si-nalsal/pcb-mantis/connector (copy).kicad_sch.txt

(kicad_sch
	(version 20260306)
	(generator "eeschema")
	(generator_version "10.0")
	(uuid "03265686-2f84-4efa-9390-2dec67647ce7")
	(paper "A4")
	(title_block
		(title "Svayamkriya Vibhava")
		(company "Aksantara ITB")
	)
	(lib_symbols
		(symbol "Connector:Conn_01x02_Pin"
			(pin_names
				(offset 1.016)
				(hide yes)
			)
			(exclude_from_sim no)
			(in_bom yes)
			(on_board yes)
			(in_pos_files yes)
			(duplicate_pin_numbers_are_jumpers no)
			(property "Reference" "J"
				(at 0 2.54 0)
				(show_name no)
				(do_not_autoplace no)
				(effects
					(font
						(size 1.27 1.27)
					)
				)
			)
			(property "Value" "Conn_01x02_Pin"
				(at 0 -5.08 0)
				(show_name no)
				(do_not_autoplace no)
				(effects
					(font
						(size 1.27 1.27)
					)
				)
			)
			(property "Footprint" ""
				(at 0 0 0)
				(show_name no)
				(do_not_autoplace no)
				(hide yes)
				(effects
					(font
						(size 1.27 1.27)
					)
				)
			)
			(property "Datasheet" ""
				(at 0 0 0)
				(show_name no)
				(do_not_autoplace no)
				(hide yes)
				(effects
					(font
						(size 1.27 1.27)
					)
				)
			)
			(property "Description" "Generic connector, single row, 01x02, script generated"
				(at 0 0 0)
				(show_name no)
				(do_not_autoplace no)
				(hide yes)
				(effects
					(font
						(size 1.27 1.27)
					)
				)
			)
			(property "ki_locked" ""
				(at 0 0 0)
				(show_name no)
				(do_not_autoplace no)
				(effects
					(font
						(size 1.27 1.27)
					)
				)
			)
			(property "ki_keywords" "connector"
				(at 0 0 0)
				(show_name no)
				(do_not_autoplace no)
				(hide yes)
				(effects
					(font
						(size 1.27 1.27)
					)
				)
			)
			(property "ki_fp_filters" "Connector*:*_1x??_*"
				(at 0 0 0)
				(show_name no)
				(do_not_autoplace no)
				(hide yes)
				(effects
					(font
						(size 1.27 1.27)
					)
				)
			)
			(symbol "Conn_01x02_Pin_1_1"
				(rectangle
					(start 0.8636 0.127)
					(end 0 -0.127)
					(stroke
						(width 0.1524)
						(type default)
					)
					(fill
						(type outline)
					)
				)
				(rectangle
					(start 0.8636 -2.413)
					(end 0 -2.667)
					(stroke
						(width 0.1524)
						(type default)
					)
					(fill
						(type outline)
					)
				)
				(polyline
					(pts
						(xy 1.27 0) (xy 0.8636 0)
					)
					(stroke
						(width 0.1524)
						(type default)
					)
					(fill
						(type none)
					)
				)
				(polyline
					(pts
						(xy 1.27 -2.54) (xy 0.8636 -2.54)
					)
					(stroke
						(width 0.1524)
						(type default)
					)
					(fill
						(type none)
					)
				)
				(pin passive line
					(at 5.08 0 180)
					(length 3.81)
					(name "Pin_1"
						(effects
							(font
								(size 1.27 1.27)
							)
						)
					)
					(number "1"
						(effects
							(font
								(size 1.27 1.27)
							)
						)
					)
				)
				(pin passive line
					(at 5.08 -2.54 180)
					(length 3.81)
					(name "Pin_2"
						(effects
							(font
								(size 1.27 1.27)
							)
						)
					)
					(number "2"
						(effects
							(font
								(size 1.27 1.27)
							)
						)
					)
				)
			)
			(embedded_fonts no)
		)
		(symbol "Connector:Conn_01x03_Socket"
			(pin_names
				(offset 1.016)
				(hide yes)
			)
			(exclude_from_sim no)
			(in_bom yes)
			(on_board yes)
			(in_pos_files yes)
			(duplicate_pin_numbers_are_jumpers no)
			(property "Reference" "J"
				(at 0 5.08 0)
				(show_name no)
				(do_not_autoplace no)
				(effects
					(font
						(size 1.27 1.27)
					)
				)
			)
			(property "Value" "Conn_01x03_Socket"
				(at 0 -5.08 0)
				(show_name no)
				(do_not_autoplace no)
				(effects
					(font
						(size 1.27 1.27)
					)
				)
			)
			(property "Footprint" ""
				(at 0 0 0)
				(show_name no)
				(do_not_autoplace no)
				(hide yes)
				(effects
					(font
						(size 1.27 1.27)
					)
				)
			)
			(property "Datasheet" ""
				(at 0 0 0)
				(show_name no)
				(do_not_autoplace no)
				(hide yes)
				(effects
					(font
						(size 1.27 1.27)
					)
				)
			)
			(property "Description" "Generic connector, single row, 01x03, script generated"
				(at 0 0 0)
				(show_name no)
				(do_not_autoplace no)
				(hide yes)
				(effects
					(font
						(size 1.27 1.27)
					)
				)
			)
			(property "ki_locked" ""
				(at 0 0 0)
				(show_name no)
				(do_not_autoplace no)
				(effects
					(font
						(size 1.27 1.27)
					)
				)
			)
			(property "ki_keywords" "connector"
				(at 0 0 0)
				(show_name no)
				(do_not_autoplace no)
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
			)
		)
		(property "MPN" ""
			(at 240.03 57.15 0)
			(hide yes)
			(show_name no)
			(do_not_autoplace no)
			(effects
				(font
					(size 1.27 1.27)
				)
			)
		)
		(pin "10"
			(uuid "5faf5ca5-a9dc-4bd5-bea4-7c678d5fadc7")
		)
		(pin "4"
			(uuid "1208e7ed-2508-4eac-b18b-d2cbbdd8cb6e")
		)
		(pin "9"
			(uuid "406bfd20-a2a9-4eb4-803e-b73969eafc6d")
		)
		(pin "7"
			(uuid "932b8ec7-872d-498e-a7df-8b2aea224fba")
		)
		(pin "3"
			(uuid "539c2599-ec2d-4190-90a8-c909d4a950bc")
		)
		(pin "2"
			(uuid "92c30c23-30dd-4c9d-af76-a7bf393b6080")
		)
		(pin "6"
			(uuid "4ee2161a-e461-4d2e-9539-8ffbe4ac3db1")
		)
		(pin "5"
			(uuid "11e90bf2-4136-402e-a8d1-76ae9172d5fe")
		)
		(pin "8"
			(uuid "fd24c3a2-98c4-43d6-949b-77af67ea0eec")
		)
		(pin "1"
			(uuid "a705ce5e-21bf-4448-98fc-6fa667d10294")
		)
		(instances
			(project "SvayamV3_IIK"
				(path "/2845b085-eb04-41a1-8594-b2a880ca4ab0/62301ec1-b8c7-4fa7-aee1-8dbd1d010312"
					(reference "J7")
					(unit 1)
				)
			)
		)
	)
	(symbol
		(lib_id "Connector:Conn_01x07_Pin")
		(at 46.99 107.95 0)
		(mirror y)
		(unit 1)
		(body_style 1)
		(exclude_from_sim no)
		(in_bom yes)
		(on_board yes)
		(in_pos_files yes)
		(dnp yes)
		(fields_autoplaced yes)
		(uuid "18c9e688-f1d2-4cd7-b8b5-5cb62be1aed3")
		(property "Reference" "J21"
			(at 46.355 95.25 0)
			(show_name no)
			(do_not_autoplace no)
			(effects
				(font
					(size 1.27 1.27)
				)
			)
		)
		(property "Value" "SPI"
			(at 46.355 97.79 0)
			(show_name no)
			(do_not_autoplace no)
			(effects
				(font
					(size 1.27 1.27)
				)
			)
		)
		(property "Footprint" "Connector_JST:JST_GH_BM07B-GHS-TBT_1x07-1MP_P1.25mm_Vertical"
			(at 46.99 107.95 0)
			(hide yes)
			(show_name no)
			(do_not_autoplace no)
			(effects
				(font
					(size 1.27 1.27)
				)
			)
		)
		(property "Datasheet" ""
			(at 46.99 107.95 0)
			(hide yes)
			(show_name no)
			(do_not_autoplace no)
			(effects
				(font
					(size 1.27 1.27)
				)
			)
		)
		(property "Description" "Generic connector, single row, 01x07, script generated"
			(at 46.99 107.95 0)
			(hide yes)
			(show_name no)
			(do_not_autoplace no)
			(effects
				(font
					(size 1.27 1.27)
				)
			)
		)
		(property "MPN" ""
			(at 46.99 107.95 0)
			(hide yes)
			(show_name no)
			(do_not_autoplace no)
			(effects
				(font
					(size 1.27 1.27)
				)
			)
		)
		(pin "6"
			(uuid "288df99f-dae5-49ea-928c-db82f384212a")
		)
		(pin "7"
			(uuid "b9f9490f-fe2d-4c1c-935e-d4dd897e21a7")
		)
		(pin "4"
			(uuid "f30de5ce-285d-4f3a-ba5a-36126d62c0cd")
		)
		(pin "2"
			(uuid "916c0bb5-cfb0-42c9-8f4e-c7ee834b80be")
		)
		(pin "3"
			(uuid "2f8645a6-8778-4034-a83e-562c17ab7f0e")
		)
		(pin "1"
			(uuid "aa54f949-fe58-489f-ac60-cde8ec75a0ca")
		)
		(pin "5"
			(uuid "d0431252-0378-4e6b-ab2e-a6c766854e29")
		)
		(instances
			(project "SvayamV3_IIK"
				(path "/2845b085-eb04-41a1-8594-b2a880ca4ab0/62301ec1-b8c7-4fa7-aee1-8dbd1d010312"
					(reference "J21")
					(unit 1)
				)
			)
		)
	)
	(symbol
		(lib_id "Device:R")
		(at 36.83 55.88 270)
		(mirror x)
		(unit 1)
		(body_style 1)
		(exclude_from_sim no)
		(in_bom yes)
		(on_board yes)
		(in_pos_files yes)
		(dnp no)
		(uuid "18f2939e-c780-4f3e-8dc2-9bac9d83a237")
		(property "Reference" "R56"
			(at 43.434 54.864 90)
			(show_name no)
			(do_not_autoplace no)
			(effects
				(font
					(size 1.27 1.27)
				)
				(justify right)
			)
		)
		(property "Value" "120"
			(at 38.862 55.88 90)
			(show_name no)
			(do_not_autoplace no)
			(effects
				(font
					(size 1.27 1.27)
				)
				(justify right)
			)
		)
		(property "Footprint" "Resistor_SMD:R_0402_1005Metric"
			(at 36.83 57.658 90)
			(hide yes)
			(show_name no)
			(do_not_autoplace no)
			(effects
				(font
					(size 1.27 1.27)
				)
			)
		)
		(property "Datasheet" ""
			(at 36.83 55.88 0)
			(hide yes)
			(show_name no)
			(do_not_autoplace no)
			(effects
				(font
					(size 1.27 1.27)
				)
			)
		)
		(property "Description" "Resistor"
			(at 36.83 55.88 0)
			(hide yes)
			(show_name no)
			(do_not_autoplace no)
			(effects
				(font
					(size 1.27 1.27)
				)
			)
		)
		(property "MPN" "0402WGF1200TCE"
			(at 36.83 55.88 0)
			(hide yes)
			(show_name no)
			(do_not_autoplace no)
			(effects
				(font
					(size 1.27 1.27)
				)
			)
		)
		(pin "1"
			(uuid "8353e9d4-af14-414b-9c09-83cc79ee870e")
		)
		(pin "2"
			(uuid "7dce7579-1e03-49c3-901d-1a2f33d9af58")
		)
		(instances
			(project "SvayamV3_IIK"
				(path "/2845b085-eb04-41a1-8594-b2a880ca4ab0/62301ec1-b8c7-4fa7-aee1-8dbd1d010312"
					(reference "R56")
					(unit 1)
				)
			)
		)
	)
	(symbol
		(lib_id "power:GND")
		(at 34.29 187.96 0)
		(unit 1)
		(body_style 1)
		(exclude_from_sim no)
		(in_bom yes)
		(on_board yes)
		(in_pos_files yes)
		(dnp no)
		(fields_autoplaced yes)
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
			(at 252.73 130.81 0)
			(hide yes)
			(show_name no)
			(do_not_autoplace no)
			(effects
				(font
					(size 1.27 1.27)
				)
			)
		)
		(property "MPN" "1040310811"
			(at 252.73 130.81 0)
			(hide yes)
			(show_name no)
			(do_not_autoplace no)
			(effects
				(font
					(size 1.27 1.27)
				)
			)
		)
		(pin "8"
			(uuid "cb6624f8-a1e8-49c2-84a5-bef0e999a261")
		)
		(pin "7"
			(uuid "d5033a53-cf56-4719-aa6e-07890199050d")
		)
		(pin "5"
			(uuid "993f321e-2bf0-49b4-9d45-fda569c61765")
		)
		(pin "6"
			(uuid "1bfad961-9bcc-41d8-80f4-651ca0a691e3")
		)
		(pin "9"
			(uuid "e06dffd2-5b84-4b25-ab86-bc74e01b0dd9")
		)
		(pin "4"
			(uuid "eb05ebf3-bc08-4bf6-b3bc-95f3cf43d655")
		)
		(pin "10"
			(uuid "8a9c7bf7-9211-48c9-ad3b-dce50b0c11e4")
		)
		(pin "1"
			(uuid "30ea762a-e999-4649-bf35-5b8d219369ba")
		)
		(pin "3"
			(uuid "5db72ffa-984e-4d56-9220-41458373f673")
		)
		(pin "2"
			(uuid "7336b55d-bf80-46e8-8c3e-e9e0fc80735a")
		)
		(instances
			(project "SvayamV3_IIK"
				(path "/2845b085-eb04-41a1-8594-b2a880ca4ab0/62301ec1-b8c7-4fa7-aee1-8dbd1d010312"
					(reference "J2")
					(unit 1)
				)
			)
		)
	)
	(symbol
		(lib_id "power:+3V3")
		(at 74.93 148.59 0)
		(unit 1)
		(body_style 1)
		(exclude_from_sim no)
		(in_bom yes)
		(on_board yes)
		(in_pos_files yes)
		(dnp no)
		(uuid "63fd7163-d494-418c-9f1c-1702d7ba05cc")
		(property "Reference" "#PWR086"
			(at 74.93 152.4 0)
			(hide yes)
			(show_name no)
			(do_not_autoplace no)
			(effects
				(font
					(size 1.27 1.27)
				)
			)
		)
		(property "Value" "+VBUS"
			(at 70.612 144.526 0)
			(show_name no)
			(do_not_autoplace no)
			(effects
				(font
					(size 1.27 1.27)
				)
				(justify left)
			)
		)
		(property "Footprint" ""
			(at 74.93 148.59 0)
			(hide yes)
			(show_name no)
			(do_not_autoplace no)
			(effects
				(font
					(size 1.27 1.27)
				)
			)
		)
		(property "Datasheet" ""
			(at 74.93 148.59 0)
			(hide yes)
			(show_name no)
			(do_not_autoplace no)
			(effects
				(font
					(size 1.27 1.27)
				)
			)
		)
		(property "Description" "Power symbol creates a global label with name \"+3V3\""
			(at 74.93 148.59 0)
			(hide yes)
			(show_name no)
			(do_not_autoplace no)
			(effects
				(font
					(size 1.27 1.27)
				)
			)
		)
		(pin "1"
			(uuid "fac0508f-6b04-46f6-8075-e6ba6fb24d24")
		)
		(instances
			(project "SvayamV3_IIK"
				(path "/2845b085-eb04-41a1-8594-b2a880ca4ab0/62301ec1-b8c7-4fa7-aee1-8dbd1d010312"
					(reference "#PWR086")
					(unit 1)
				)
			)
		)
	)
	(symbol
		(lib_id "Connector:Conn_01x03_Socket")
		(at 104.14 44.45 0)
		(unit 1)
		(body_style 1)
		(exclude_from_sim no)
		(in_bom yes)
		(on_board yes)
		(in_pos_files yes)
		(dnp yes)
		(fields_autoplaced yes)
		(uuid "66f18fe3-e061-4741-9793-27d07f73b41f")
		(property "Reference" "J18"
			(at 105.41 43.1799 0)
			(show_name no)
			(do_not_autoplace no)
			(effects
				(font
					(size 1.27 1.27)
				)
				(justify left)
			)
		)
		(property "Value" "BUZZER"
			(at 105.41 45.7199 0)
			(show_name no)
			(do_not_autoplace no)
			(effects
				(font
					(size 1.27 1.27)
				)
				(justify left)
			)
		)
		(property "Footprint" "Connector_JST:JST_GH_BM03B-GHS-TBT_1x03-1MP_P1.25mm_Vertical"
			(at 104.14 44.45 0)
			(hide yes)
			(show_name no)
			(do_not_autoplace no)
			(effects
				(font
					(size 1.27 1.27)
				)
			)
		)
		(property "Datasheet" ""
			(at 104.14 44.45 0)
			(hide yes)
			(show_name no)
			(do_not_autoplace no)
			(effects
				(font
					(size 1.27 1.27)
				)
			)
		)
		(property "Description" "Generic connector, single row, 01x03, script generated"
			(at 104.14 44.45 0)
			(hide yes)
			(show_name no)
			(do_not_autoplace no)
			(effects
				(font
					(size 1.27 1.27)
				)
			)
		)
		(property "MPN" ""
			(at 104.14 44.45 0)
			(hide yes)
			(show_name no)
			(do_not_autoplace no)
			(effects
				(font
					(size 1.27 1.27)
				)
			)
		)
		(pin "3"
			(uuid "60e7030a-febb-4282-b92f-761420e810f0")
		)
		(pin "1"
			(uuid "5442ed96-bc10-46ac-b1f5-2626b62a5412")
		)
		(pin "2"
			(uuid "1a9f50e6-1e32-49f7-9bb9-00bd1e115986")
		)
		(instances
			(project "SvayamV3_IIK"
				(path "/2845b085-eb04-41a1-8594-b2a880ca4ab0/62301ec1-b8c7-4fa7-aee1-8dbd1d010312"
					(reference "J18")
					(unit 1)
				)
			)
		)
	)
	(symbol
		(lib_id "Connector:Conn_01x06_Pin")
		(at 240.03 29.21 0)
		(unit 1)
		(body_style 1)
		(exclude_from_sim no)
		(in_bom yes)
		(on_board yes)
		(in_pos_files yes)
		(dnp yes)
		(uuid "70888625-afd2-4ff5-a54f-43112737d458")
		(property "Reference" "J4"
			(at 240.665 19.05 0)
			(show_name no)
			(do_not_autoplace no)
			(effects
				(font
					(size 1.27 1.27)
				)
			)
		)
		(property "Value" "S_TOP_PWR"
			(at 240.665 21.59 0)
			(show_name no)
			(do_not_autoplace no)
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
				(path "/2845b085-eb04-41a1-8594-b2a880ca4ab0/62301ec1-b8c7-4fa7-aee1-8dbd1d010312"
					(reference "R25")
					(unit 1)
				)
			)
		)
	)
	(symbol
		(lib_id "Connector:USB_C_Receptacle_USB2.0_16P")
		(at 34.29 163.83 0)
		(unit 1)
		(body_style 1)
		(exclude_from_sim no)
		(in_bom yes)
		(on_board yes)
		(in_pos_files yes)
		(dnp no)
		(fields_autoplaced yes)
		(uuid "c4829fad-b5e2-4201-a339-db18e4ded1f6")
		(property "Reference" "J1"
			(at 34.29 140.97 0)
			(show_name no)
			(do_not_autoplace no)
			(effects
				(font
					(size 1.27 1.27)
				)
			)
		)
		(property "Value" "USB_C_Receptacle_USB2.0_16P"
			(at 34.29 143.51 0)
			(show_name no)
			(do_not_autoplace no)
			(effects
				(font
					(size 1.27 1.27)
				)
			)
		)
		(property "Footprint" "easyeda2kicad:USB-C-SMD_TYPE-C16PIN"
			(at 38.1 163.83 0)
			(hide yes)
			(show_name no)
			(do_not_autoplace no)
			(effects
				(font
					(size 1.27 1.27)
				)
			)
		)
		(property "Datasheet" "https://www.usb.org/sites/default/files/documents/usb_type-c.zip"
			(at 38.1 163.83 0)
			(hide yes)
			(show_name no)
			(do_not_autoplace no)
			(effects
				(font
					(size 1.27 1.27)
				)
			)
		)
		(property "Description" "USB 2.0-only 16P Type-C Receptacle connector"
			(at 34.29 163.83 0)
			(hide yes)
			(show_name no)
			(do_not_autoplace no)
			(effects
				(font
					(size 1.27 1.27)
				)
			)
		)
		(property "MPN" "TYPE-C16PIN"
			(at 34.29 163.83 0)
			(hide yes)
			(show_name no)
			(do_not_autoplace no)
			(effects
				(font
					(size 1.27 1.27)
				)
			)
		)
		(pin "B8"
			(uuid "db181596-cf46-47b6-a408-663041a7f4fd")
		)
		(pin "A7"
			(uuid "c0e09dfd-21cf-4c7e-bd06-315c416275d8")
		)
		(pin "A1"
			(uuid "74b0fce0-470e-4f8b-9161-8ce03450caf1")
		)
		(pin "B9"
			(uuid "69491447-4349-4a7c-a44a-8b59ee2ec28e")
		)
		(pin "A4"
			(uuid "0c3d424d-8a51-4b5d-a7ea-090fd09bc773")
		)
		(pin "B4"
			(uuid "c3caafd2-da87-4897-a4a4-4b574669baf9")
		)
		(pin "B1"
			(uuid "2f8629b2-707a-463e-8b76-95569479ec8e")
		)
		(pin "B7"
			(uuid "52371f4a-9e05-443f-989e-7d06c8298733")
		)
		(pin "A5"
			(uuid "d6624947-ba8a-4f8c-9232-5fb9c6404ed8")
		)
		(pin "B6"
			(uuid "035ad77f-19e3-431d-a522-fd0e5fde45c7")
		)
		(pin "A12"
			(uuid "10726012-93a9-4aa6-b8f0-2641798eb760")
		)
		(pin "A9"
			(uuid "70ab6524-c4cd-4f23-b672-b27a699ab554")
		)
		(pin "A8"
			(uuid "8048cba8-2139-4dd7-bb9a-27b2c1656934")
		)
		(pin "B5"
			(uuid "c59acc48-44ca-4bcc-abdf-0167ccc85853")
		)
		(pin "S1"
			(uuid "5e77efb9-58d6-47e2-8f87-1d94c796d1b4")
		)
		(pin "B12"
			(uuid "077311d9-3f3e-4e68-9a96-4f02640ec5a4")
		)
		(pin "A6"
			(uuid "9e67610e-7504-4989-97e8-7b37c6cc6fc5")
		)
		(instances
			(project "SvayamV3_IIK"
				(path "/2845b085-eb04-41a1-8594-b2a880ca4ab0/62301ec1-b8c7-4fa7-aee1-8dbd1d010312"
					(reference "J1")
					(unit 1)
				)
			)
		)
	)
	(symbol
		(lib_id "power:GND")
		(at 124.46 46.99 0)
		(unit 1)
		(body_style 1)
		(exclude_from_sim no)
		(in_bom yes)
		(on_board yes)
		(in_pos_files yes)
		(dnp no)
		(fields_autoplaced yes)
		(uuid "c66d8db5-72ca-4785-af80-80bd893ed88d")
		(property "Reference" "#PWR066"
			(at 124.46 53.34 0)
			(hide yes)
			(show_name no)
			(do_not_autoplace no)
			(effects
				(font
					(size 1.27 1.27)
				)
			)
		)
		(property "Value" "GND"
			(at 124.46 52.07 0)
			(hide yes)
			(show_name no)
			(do_not_autoplace no)
			(effects
				(font
					(size 1.27 1.27)
				)
			)
		)
		(property "Footprint" ""
			(at 124.46 46.99 0)
			(hide yes)
			(show_name no)
			(do_not_autoplace no)
			(effects
				(font
					(size 1.27 1.27)
				)
			)
		)
		(property "Datasheet" ""
			(at 124.46 46.99 0)
			(hide yes)
			(show_name no)
			(do_not_autoplace no)
			(effects
				(font
					(size 1.27 1.27)
				)
			)
		)
		(property "Description" "Power symbol creates a global label with name \"GND\" , ground"
			(at 124.46 46.99 0)
			(hide yes)
			(show_name no)
			(do_not_autoplace no)
			(effects
				(font
					(size 1.27 1.27)
				)
			)
		)
		(pin "1"
			(uuid "8cca001b-2362-4ba5-9bf1-b4a389a86623")
		)
		(instances
			(project "SvayamV3_IIK"
				(path "/2845b085-eb04-41a1-8594-b2a880ca4ab0/62301ec1-b8c7-4fa7-aee1-8dbd1d010312"
					(reference "#PWR066")
					(unit 1)
				)
			)
		)
	)
	(symbol
		(lib_id "power:GND")
		(at 82.55 116.84 0)
		(unit 1)
		(body_style 1)
		(exclude_from_sim no)
		(in_bom yes)
		(on_board yes)
		(in_pos_files yes)
		(dnp no)
		(fields_autoplaced yes)
		(uuid "ca408961-e181-4023-bc09-9be4eecc3f4a")
		(property "Reference" "#PWR083"
			(at 82.55 123.19 0)
			(hide yes)
			(show_name no)
			(do_not_autoplace no)
			(effects
				(font
					(size 1.27 1.27)
				)
			)
		)
		(property "Value" "GND"
			(at 82.55 121.92 0)
			(hide yes)
			(show_name no)
			(do_not_autoplace no)
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
		(pin "6"
			(uuid "53d4a27d-80dc-40ea-b209-8d5194c79de0")
		)
		(pin "5"
			(uuid "7b395a92-bbfb-4322-a0f9-9bb482e9858a")
		)
		(pin "8"
			(uuid "9f4d6d41-09d1-4738-82e4-76208527cabb")
		)
		(pin "1"
			(uuid "095797fb-270a-4e6a-b961-59d8233d917d")
		)
		(instances
			(project "SvayamV3_IIK"
				(path "/2845b085-eb04-41a1-8594-b2a880ca4ab0/62301ec1-b8c7-4fa7-aee1-8dbd1d010312"
					(reference "J6")
					(unit 1)
				)
			)
		)
	)
	(symbol
		(lib_id "Device:R")
		(at 212.09 34.29 270)
		(mirror x)
		(unit 1)
		(body_style 1)
		(exclude_from_sim no)
		(in_bom yes)
		(on_board yes)
		(in_pos_files yes)
		(dnp no)
		(uuid "ff7dfa34-54f1-4ce1-b958-6582d1e44b65")
		(property "Reference" "R30"
			(at 218.694 33.274 90)
			(show_name no)
			(do_not_autoplace no)
			(effects
				(font
					(size 1.27 1.27)
				)
				(justify right)
			)
		)
		(property "Value" "120"
			(at 214.122 34.29 90)
			(show_name no)
			(do_not_autoplace no)
			(effects
				(font
					(size 1.27 1.27)
				)
				(justify right)
			)
		)
		(property "Footprint" "Resistor_SMD:R_0402_1005Metric"
			(at 212.09 36.068 90)
			(hide yes)
			(show_name no)
			(do_not_autoplace no)
			(effects
				(font
					(size 1.27 1.27)
				)
			)
		)
		(property "Datasheet" ""
			(at 212.09 34.29 0)
			(hide yes)
			(show_name no)
			(do_not_autoplace no)
			(effects
				(font
					(size 1.27 1.27)
				)
			)
		)
		(property "Description" "Resistor"
			(at 212.09 34.29 0)
			(hide yes)
			(show_name no)
			(do_not_autoplace no)
			(effects
				(font
					(size 1.27 1.27)
				)
			)
		)
		(property "MPN" "0402WGF1200TCE"
			(at 212.09 34.29 0)
			(hide yes)
			(show_name no)
			(do_not_autoplace no)
			(effects
				(font
					(size 1.27 1.27)
				)
			)
		)
		(pin "1"
			(uuid "c29a343e-6693-4ea5-8234-664a20f62edb")
		)
		(pin "2"
			(uuid "2394d375-28b8-440f-bd87-5712573b2a9d")
		)
		(instances
			(project "SvayamV3_IIK"
				(path "/2845b085-eb04-41a1-8594-b2a880ca4ab0/62301ec1-b8c7-4fa7-aee1-8dbd1d010312"
					(reference "R30")
					(unit 1)
				)
			)
		)
	)
)
