si-nalsal/pcb-mantis/docs/images/pcb-bottom.png

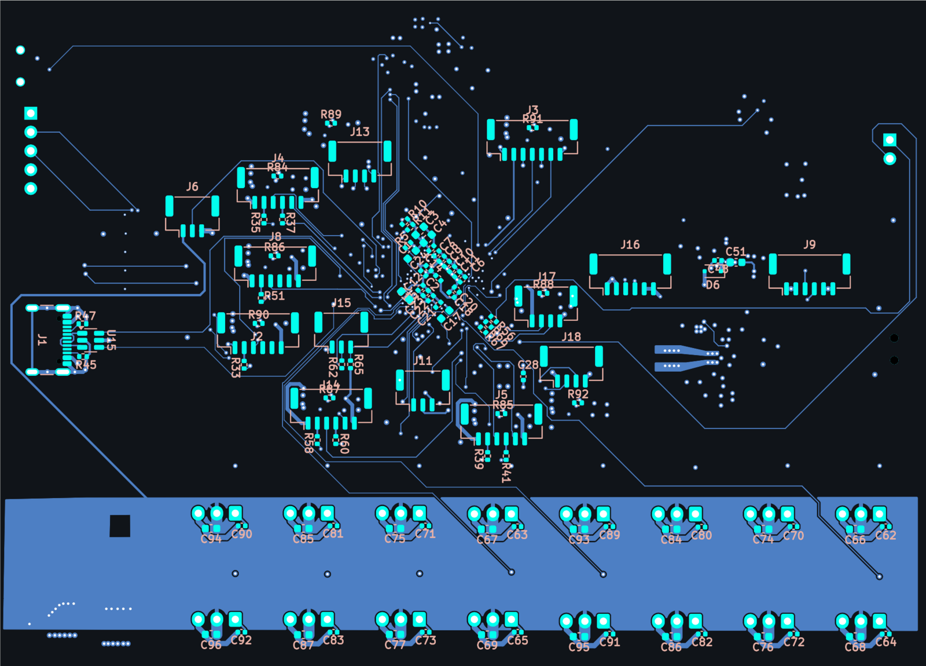
docs/images/pcb-bottom.png
