si-nalsal/pcb-mantis/docs/bom.csv

Refs | Value | Footprint | MPN | LCSC
C1,C4,C59,C66-C69,C74-C77,C79,C84-C87,C93-C114 | 1u | Capacitor_SMD:C_0603_1608Metric | CL10A105KB8NNNC
C2,C5-C12,C14,C15,C18,C20-C39,C44,C45,C48,C49,C60,C62-C65,C70-C73,C80-C83,C88-C92 | 100n | Capacitor_SMD:C_0402_1005Metric | CL05B104KB54PNC
C3,C42,C43,C55-C58 | 4u7 | Capacitor_SMD:C_0603_1608Metric | CL10A475KO8NNNC
C13,C16 | 33p | Capacitor_SMD:C_0402_1005Metric | 0402CG330J500NT
C17,C19 | 2u2 | Capacitor_SMD:C_0603_1608Metric | CL10A225KO8NNNC
C40,C41 | 10u | Capacitor_SMD:C_0805_2012Metric
C46,C50,C51,C61 | 10u | Capacitor_SMD:C_0603_1608Metric | CL10A106MA8NRNC
C47 | 100n | Capacitor_SMD:C_0805_2012Metric
C52-C54 | 22u | Capacitor_SMD:C_0805_2012Metric
C78 | 220u | Capacitor_SMD:CP_Elec_6.3x7.7
D1 | PWR | Diode_SMD:D_0603_1608Metric | NCD0603R1
D2 | BOOT | Diode_SMD:D_0603_1608Metric | NCD0603R1
D3 | STAT | Diode_SMD:D_0603_1608Metric | NCD0603R1
D4,D5,D8 | SMAJ6.0A | Diode_SMD:D_SMA
D6,D7 | PMEG1030EJ,115 | Diode_SMD:D_SOD-323F | PMEG1030EJ,115
J1 | USB_C_Receptacle_USB2.0_16P | easyeda2kicad:USB-C-SMD_TYPE-C16PIN | TYPE-C16PIN
J2 | GPS | Connector_JST:JST_GH_BM06B-GHS-TBT_1x06-1MP_P1.25mm_Vertical
J3 | SPI | Connector_JST:JST_GH_BM07B-GHS-TBT_1x07-1MP_P1.25mm_Vertical
J4 | TELEM1 | Connector_JST:JST_GH_BM06B-GHS-TBT_1x06-1MP_P1.25mm_Vertical
J5 | TELEM2 | Connector_JST:JST_GH_BM06B-GHS-TBT_1x06-1MP_P1.25mm_Vertical
J6 | SBUS | Connector_JST:JST_GH_BM03B-GHS-TBT_1x03-1MP_P1.25mm_Vertical
J7 | Conn_01x05_Pin | Connector_PinHeader_2.54mm:PinHeader_1x05_P2.54mm_Vertical
J8 | SERIAL4 | Connector_JST:JST_GH_BM06B-GHS-TBT_1x06-1MP_P1.25mm_Vertical
J9 | POWER1 | Connector_JST:JST_GH_BM06B-GHS-TBT_1x06-1MP_P1.25mm_Vertical
J10 | Micro_SD_Card_Det1 | Svayam:104031-0811_MOL | 1040310811
J11 | BUZZER | Connector_JST:JST_GH_BM03B-GHS-TBT_1x03-1MP_P1.25mm_Vertical
J12 | ADC | Connector_PinHeader_2.54mm:PinHeader_1x02_P2.54mm_Vertical
J13 | CAN | Connector_JST:JST_GH_BM04B-GHS-TBT_1x04-1MP_P1.25mm_Vertical
J14 | SERIAL5 | Connector_JST:JST_GH_BM06B-GHS-TBT_1x06-1MP_P1.25mm_Vertical
J15 | SAFETY | Connector_JST:JST_GH_BM03B-GHS-TBT_1x03-1MP_P1.25mm_Vertical
J16 | POWER2 | Connector_JST:JST_GH_BM06B-GHS-TBT_1x06-1MP_P1.25mm_Vertical
J17 | I2C | Connector_JST:JST_GH_BM04B-GHS-TBT_1x04-1MP_P1.25mm_Vertical
J18 | CAN2 | Connector_JST:JST_GH_BM04B-GHS-TBT_1x04-1MP_P1.25mm_Vertical
J19 | Channel 1 | Connector_JST:JST_XH_B3B-XH-A_1x03_P2.50mm_Vertical
J20 | Channel 5 | Connector_JST:JST_XH_B3B-XH-A_1x03_P2.50mm_Vertical
J21 | Channel 9 | Connector_JST:JST_XH_B3B-XH-A_1x03_P2.50mm_Vertical
J22 | Channel 13 | Connector_JST:JST_XH_B3B-XH-A_1x03_P2.50mm_Vertical
J23 | Channel 2 | Connector_JST:JST_XH_B3B-XH-A_1x03_P2.50mm_Vertical
J24 | Channel 6 | Connector_JST:JST_XH_B3B-XH-A_1x03_P2.50mm_Vertical
J25 | Channel 10 | Connector_JST:JST_XH_B3B-XH-A_1x03_P2.50mm_Vertical
J26 | Channel 14 | Connector_JST:JST_XH_B3B-XH-A_1x03_P2.50mm_Vertical
J27 | Channel 3 | Connector_JST:JST_XH_B3B-XH-A_1x03_P2.50mm_Vertical
J28 | Channel 7 | Connector_JST:JST_XH_B3B-XH-A_1x03_P2.50mm_Vertical
J29 | Channel 11 | Connector_JST:JST_XH_B3B-XH-A_1x03_P2.50mm_Vertical
J30 | Channel 15 | Connector_JST:JST_XH_B3B-XH-A_1x03_P2.50mm_Vertical
J31 | Channel 4 | Connector_JST:JST_XH_B3B-XH-A_1x03_P2.50mm_Vertical
J32 | Channel 8 | Connector_JST:JST_XH_B3B-XH-A_1x03_P2.50mm_Vertical
J33 | Channel 12 | Connector_JST:JST_XH_B3B-XH-A_1x03_P2.50mm_Vertical
J34 | Channel 16 | Connector_JST:JST_XH_B3B-XH-A_1x03_P2.50mm_Vertical
L1 | 1.5u | Svayam:L_Coilcraft_XxL4020
Q1 | AO3400A | Package_TO_SOT_SMD:SOT-23 | AO3400A
R1 | 330 | Resistor_SMD:R_0402_1005Metric | 0402WGF3300TCE
R2,R3,R7,R8,R10,R11,R65 | 1k5 | Resistor_SMD:R_0402_1005Metric | 0402WGF1501TCE
R4-R6,R9,R12,R31,R53-R57,R63,R64 | 10k | Resistor_SMD:R_0402_1005Metric | 0402WGF1002TCE
R13,R14,R33-R42,R51,R52,R58-R61,R66-R83 | 120 | Resistor_SMD:R_0402_1005Metric | 0402WGF1200TCE
R15,R21 | 10k | Resistor_SMD:R_0805_2012Metric
R16,R18 | 22k | Resistor_SMD:R_0402_1005Metric | 0402WGF2202TCE
R17,R19,R23,R45,R47,R49 | 5k1 | Resistor_SMD:R_0402_1005Metric | 0402WGF5101TCE
R20,R25,R29 | 100k | Resistor_SMD:R_0805_2012Metric
R22 | 15k | Resistor_SMD:R_0402_1005Metric | 0402WGF1502TCE
R24,R84,R85 | 33k | Resistor_SMD:R_0402_1005Metric | 0402WGF3302TCE
R26,R30 | 100k | Resistor_SMD:R_0402_1005Metric | 0402WGF1003TCE
R27 | 68k | Resistor_SMD:R_0805_2012Metric
R28 | 13k | Resistor_SMD:R_0805_2012Metric
R32,R43,R44,R46,R48 | 51k | Resistor_SMD:R_0402_1005Metric | 0402WGF5102TCE
R50 | 10 | Resistor_SMD:R_0402_1005Metric | 0402WGF100JTCE
R62 | 49.9 | Resistor_SMD:R_0402_1005Metric | 0402WGF499JTCE
R86,R87 | 75k | Resistor_SMD:R_0402_1005Metric
R88,R91 | 110k | Resistor_SMD:R_0402_1005Metric
R89,R92 | 47k | Resistor_SMD:R_0402_1005Metric
R90 | 56k | Resistor_SMD:R_0402_1005Metric
SW1 | SK-3296S-01-L3 | easyeda2kicad:SW-SMD_SK-3296S-01-L3 | SK-3296S-01-L3
SW2 | TS-1010A-B | easyeda2kicad:SW-SMD_TS-1010A-B | TS-1010A-B
U1 | STM32H743IIK6 | Package_BGA:UFBGA-201_10x10mm_Layout15x15_P0.65mm | STM32H743IIK6
U2 | FM25CL64B | Package_SO:SOIC-8_3.9x4.9mm_P1.27mm | FM25CL64B-GTR
U3,U4 | TJA1051TK-3 | Package_DFN_QFN:DFN-8-1EP_3x3mm_P0.65mm_EP1.55x2.4mm | TJA1051TK/3,118
U5 | BMP388 | Svayam:XDCR_BMP388 | BMP388
U6 | DPS310XTSA1 | Svayam:XDCR_DPS310XTSA1
U7 | BMI088 | Svayam:PQFN50P450X300X100-16N | BMI088
U8 | BMI270 | Svayam:XDCR_BMI270 | BMI270
U9 | BMM150 | Package_CSP:WLCSP-12_1.56x1.56mm_P0.4mm | BMM150
U10 | TPS2120YFPR | Package_BGA:Texas_YFP0020_DSBGA-20_1.588x1.988mm_Layout4x5_P0.4mm | TPS2120YFPR
U11 | TPS63070 | Svayam:VQFN-HR-15
U12,U13 | RT9080-33GJ5 | Package_TO_SOT_SMD:TSOT-23-5 | RT9080-33GJ5
U14 | AP22804AW5 | Package_TO_SOT_SMD:SOT-23-5 | AP22804AW5-7
U15 | USBLC6-2SC6 | Package_TO_SOT_SMD:SOT-23-6 | USBLC6-2SC6
U16-U24 | TPS2553DBVT | Svayam:SOT95P280X145-6N
Y1 | X50328MSB2GI | Crystal:Crystal_SMD_5032-2Pin_5.0x3.2mm | X50328MSB2GI
