si-nalsal/pcb-mantis/docs/schematic.pdf

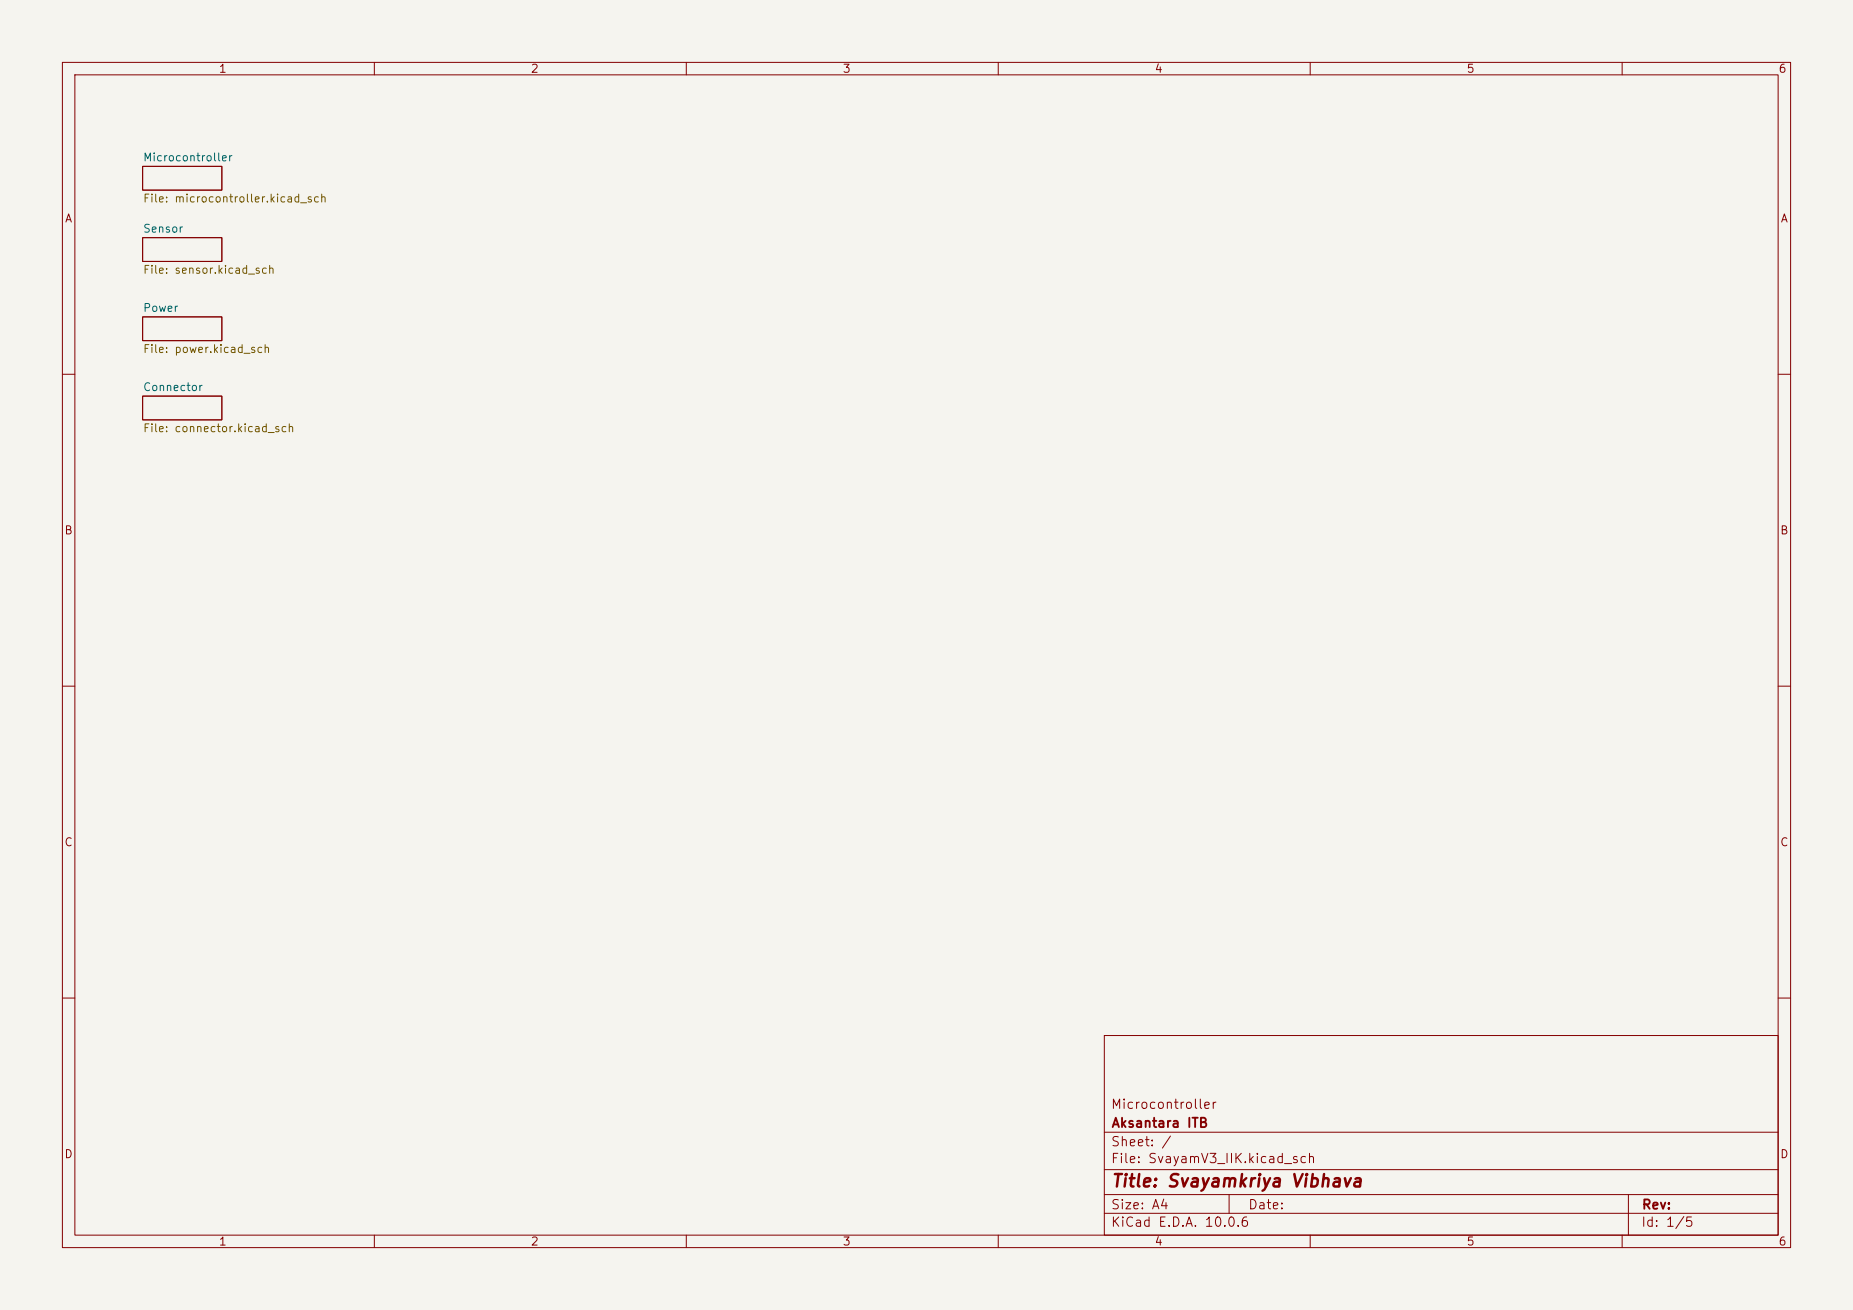
[picture p3: page 1]

Power File: power.kicad_sch Connector File: connector.kicad_sch Sensor File: sensor.kicad_sch Microcontroller File: microcontroller.kicad_sch

Size: A4 | Rev:
KiCad E.D.A. 10.0.6 | Id: 1/5

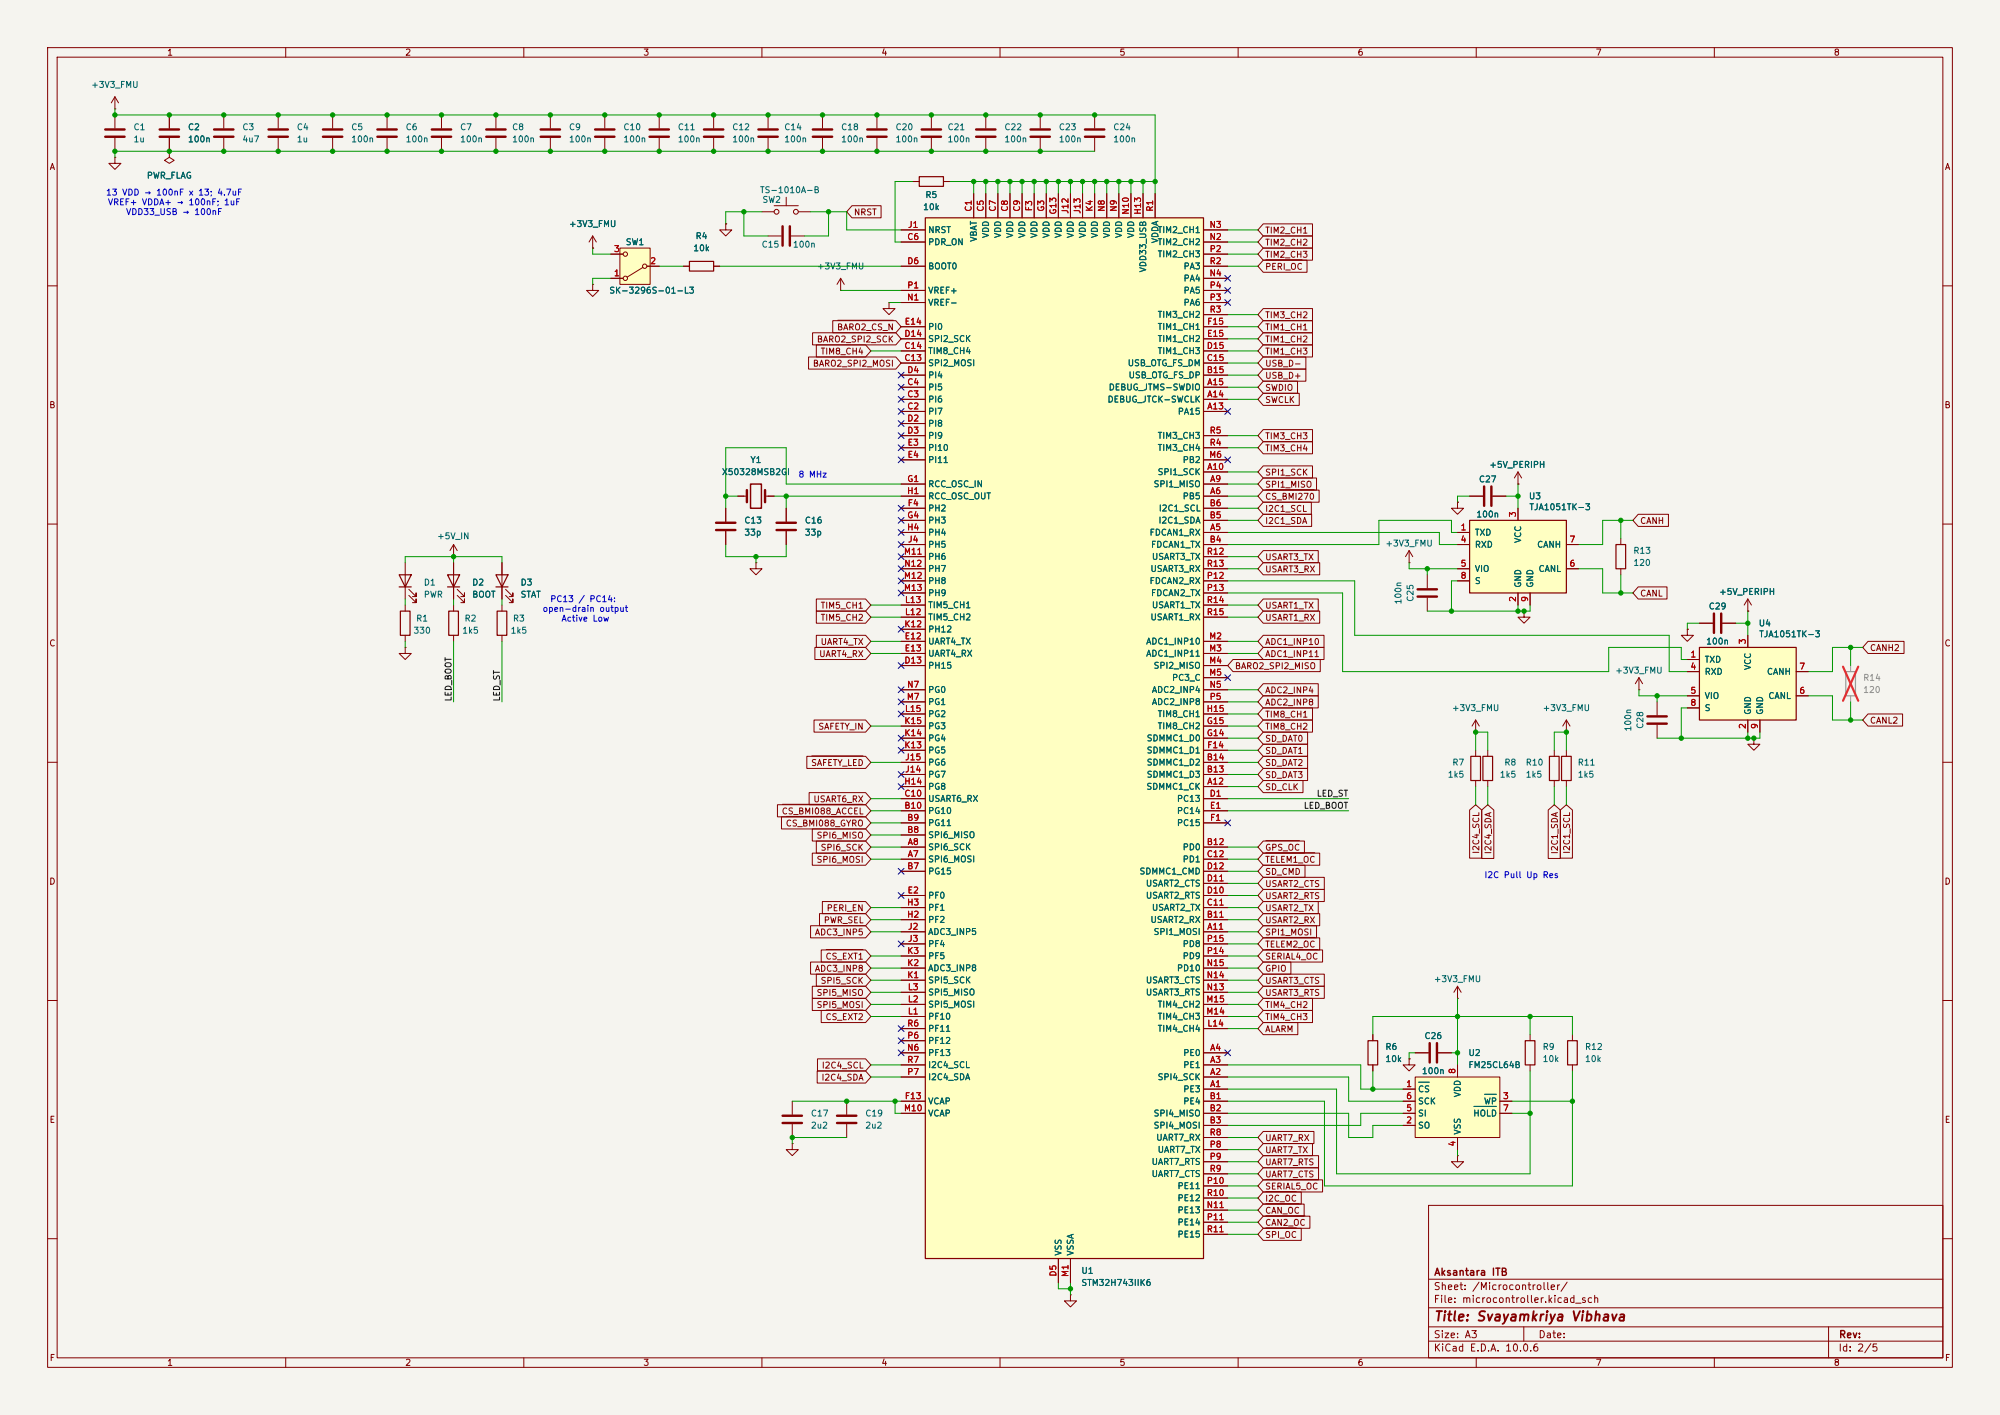
[picture p4: page 2]

LED_BOOT LED_ST PC13 / PC14: open-drain output Active Low

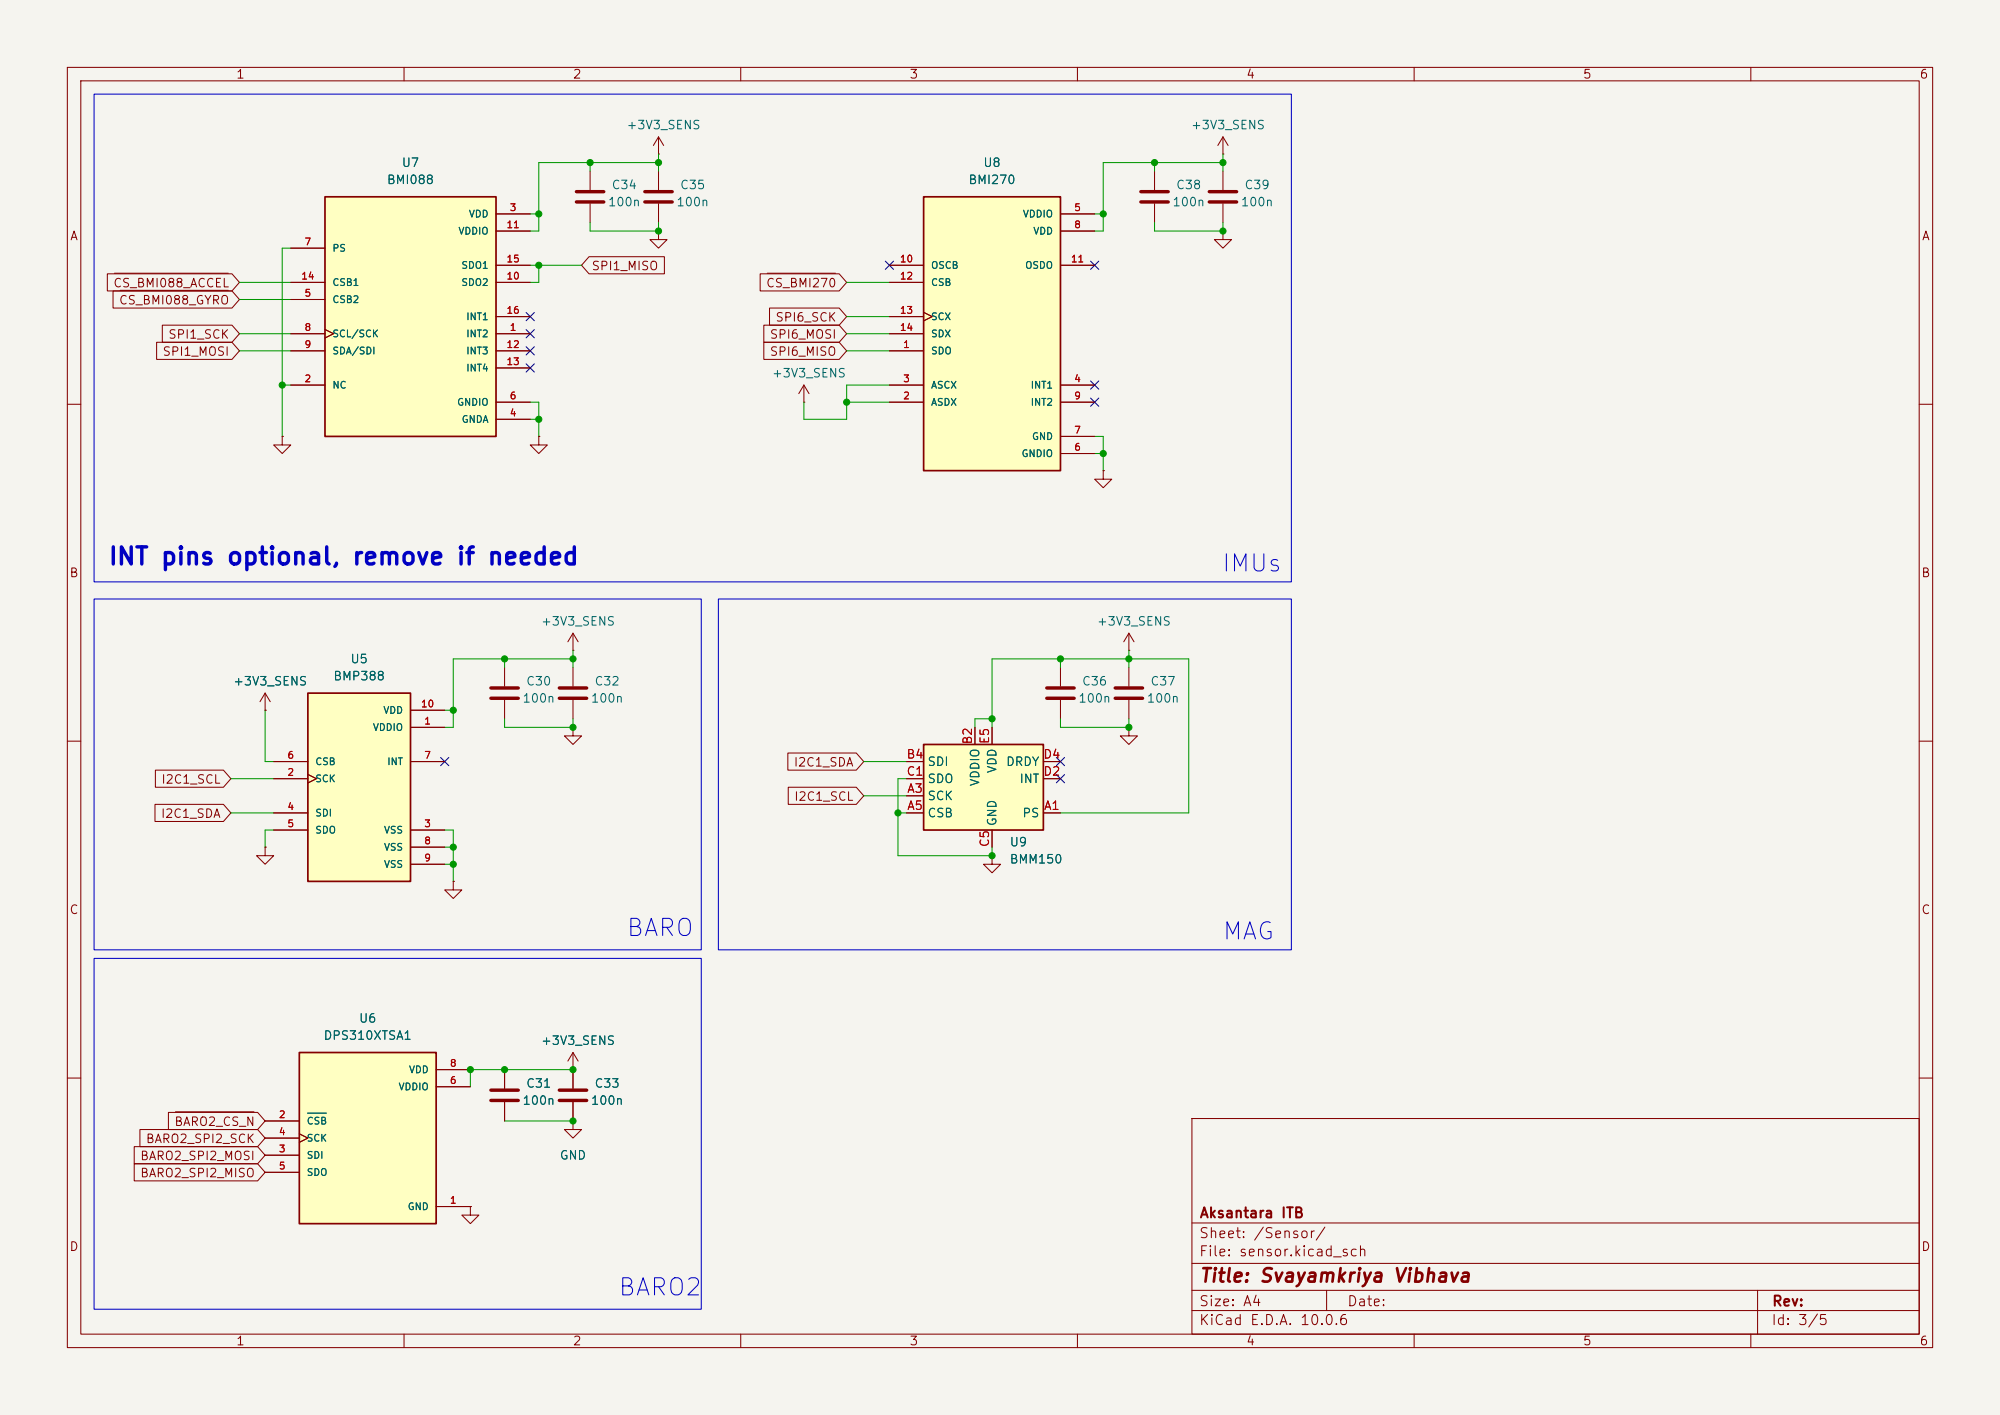
[picture p5: page 3]

BARO2

Size: A4 | Rev:

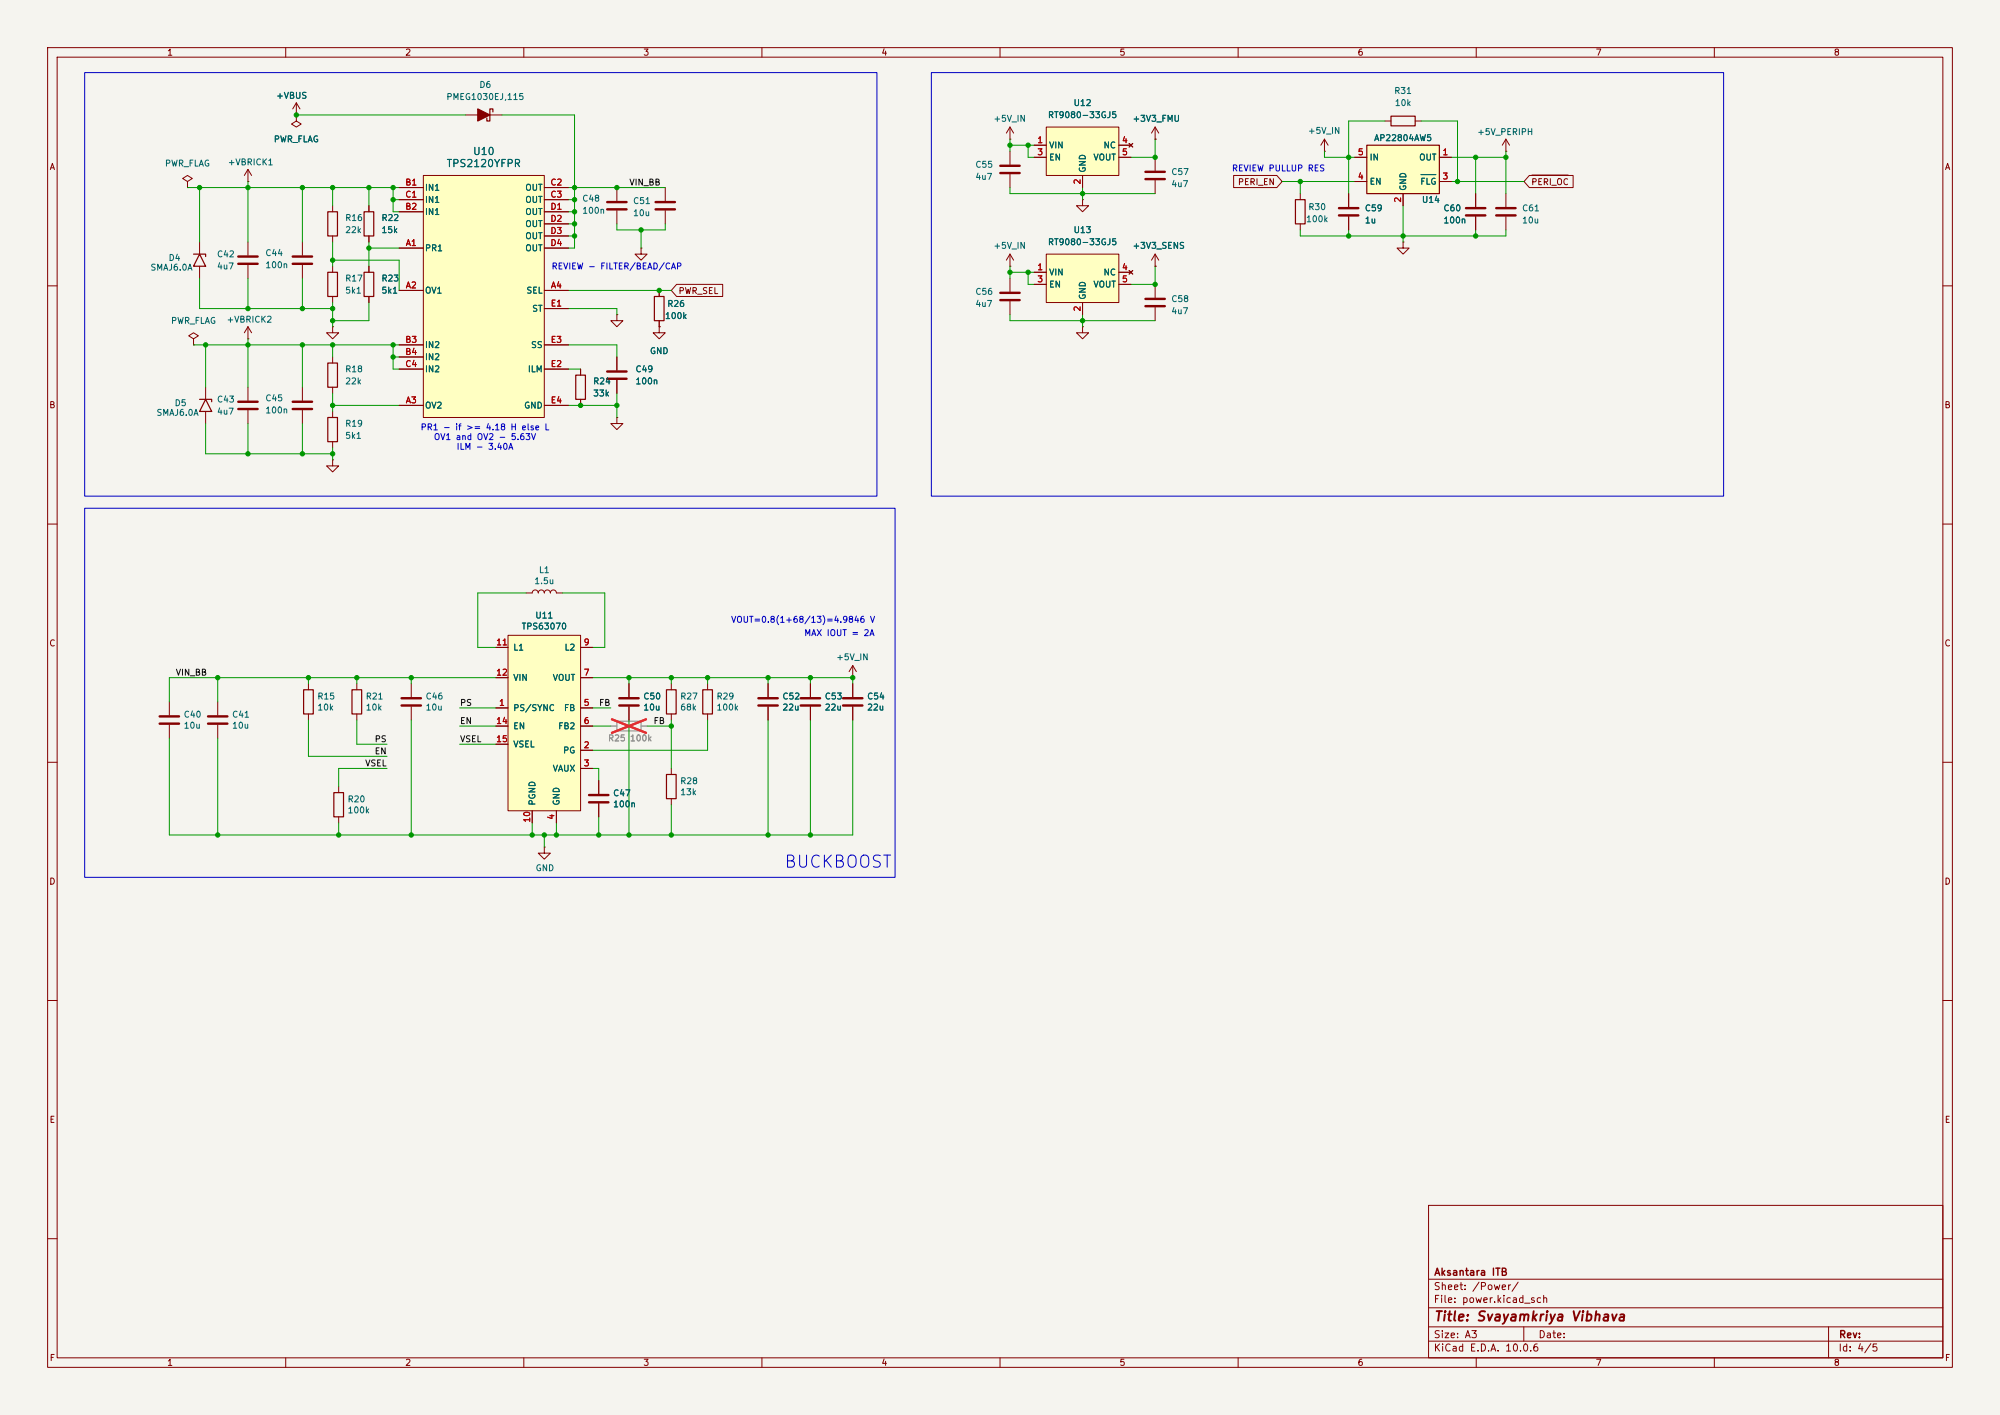
[picture p6: page 4]

VOUT=0.8(1+68/13)=4.9846 V PR1 - if >= 4.18 H else L OV1 and OV2 - 5.63V

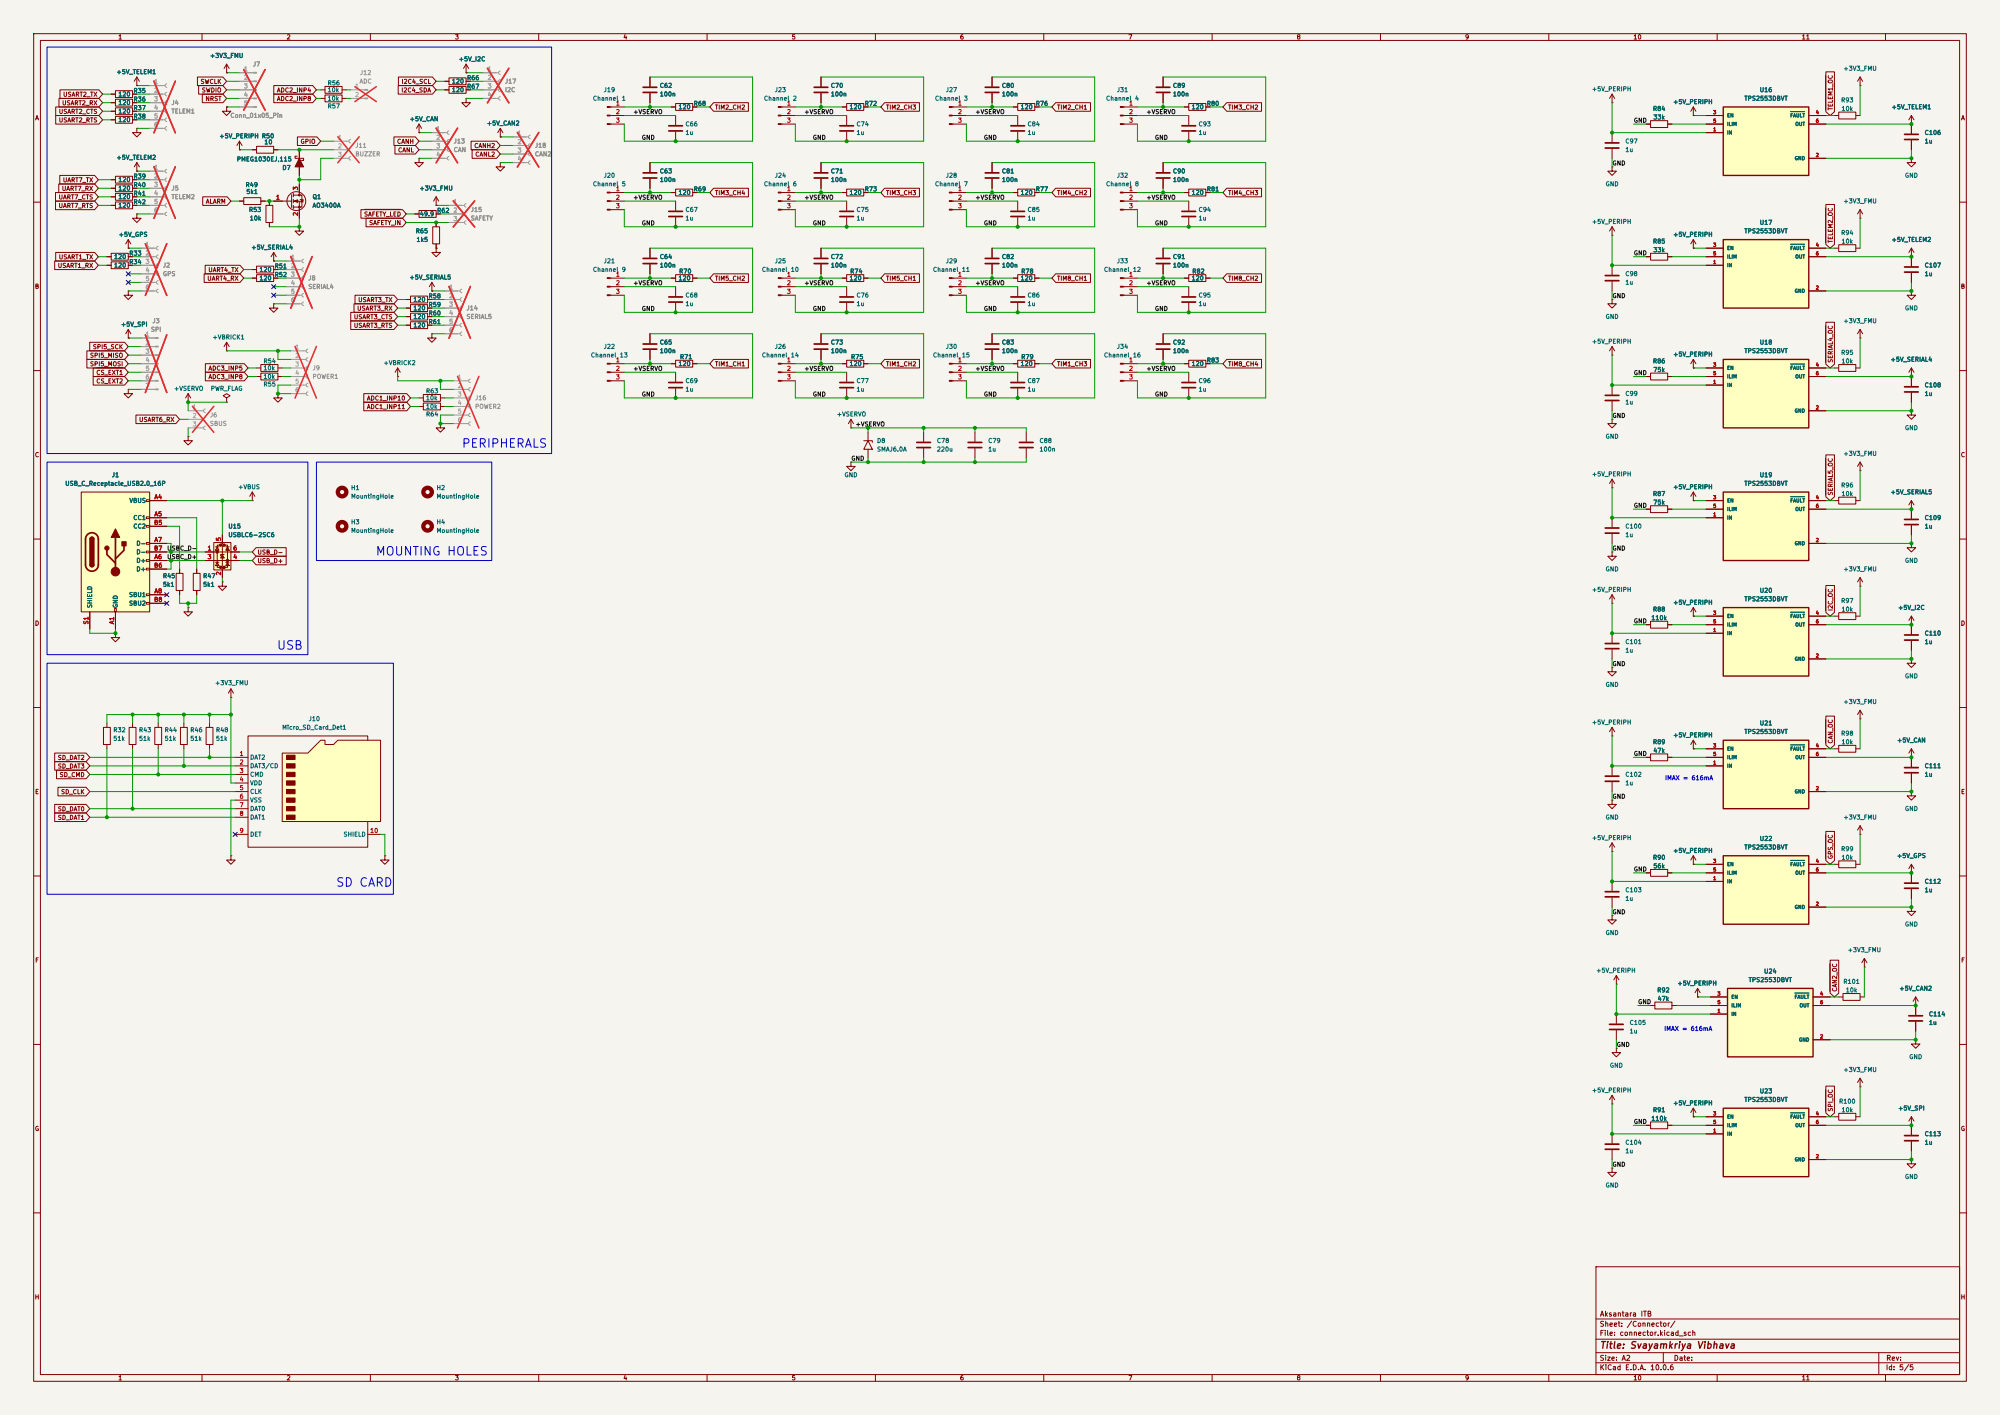
[picture p7: page 5]

DAT2 1 DAT3/CD 2 CMD 3

VDD 4 CLK 5
