si-nalsal/pcb-mantis/SvayamV3_IIK.kicad_pcb

## KiCad design SvayamV3_IIK.kicad_pcb (2026-11-13)

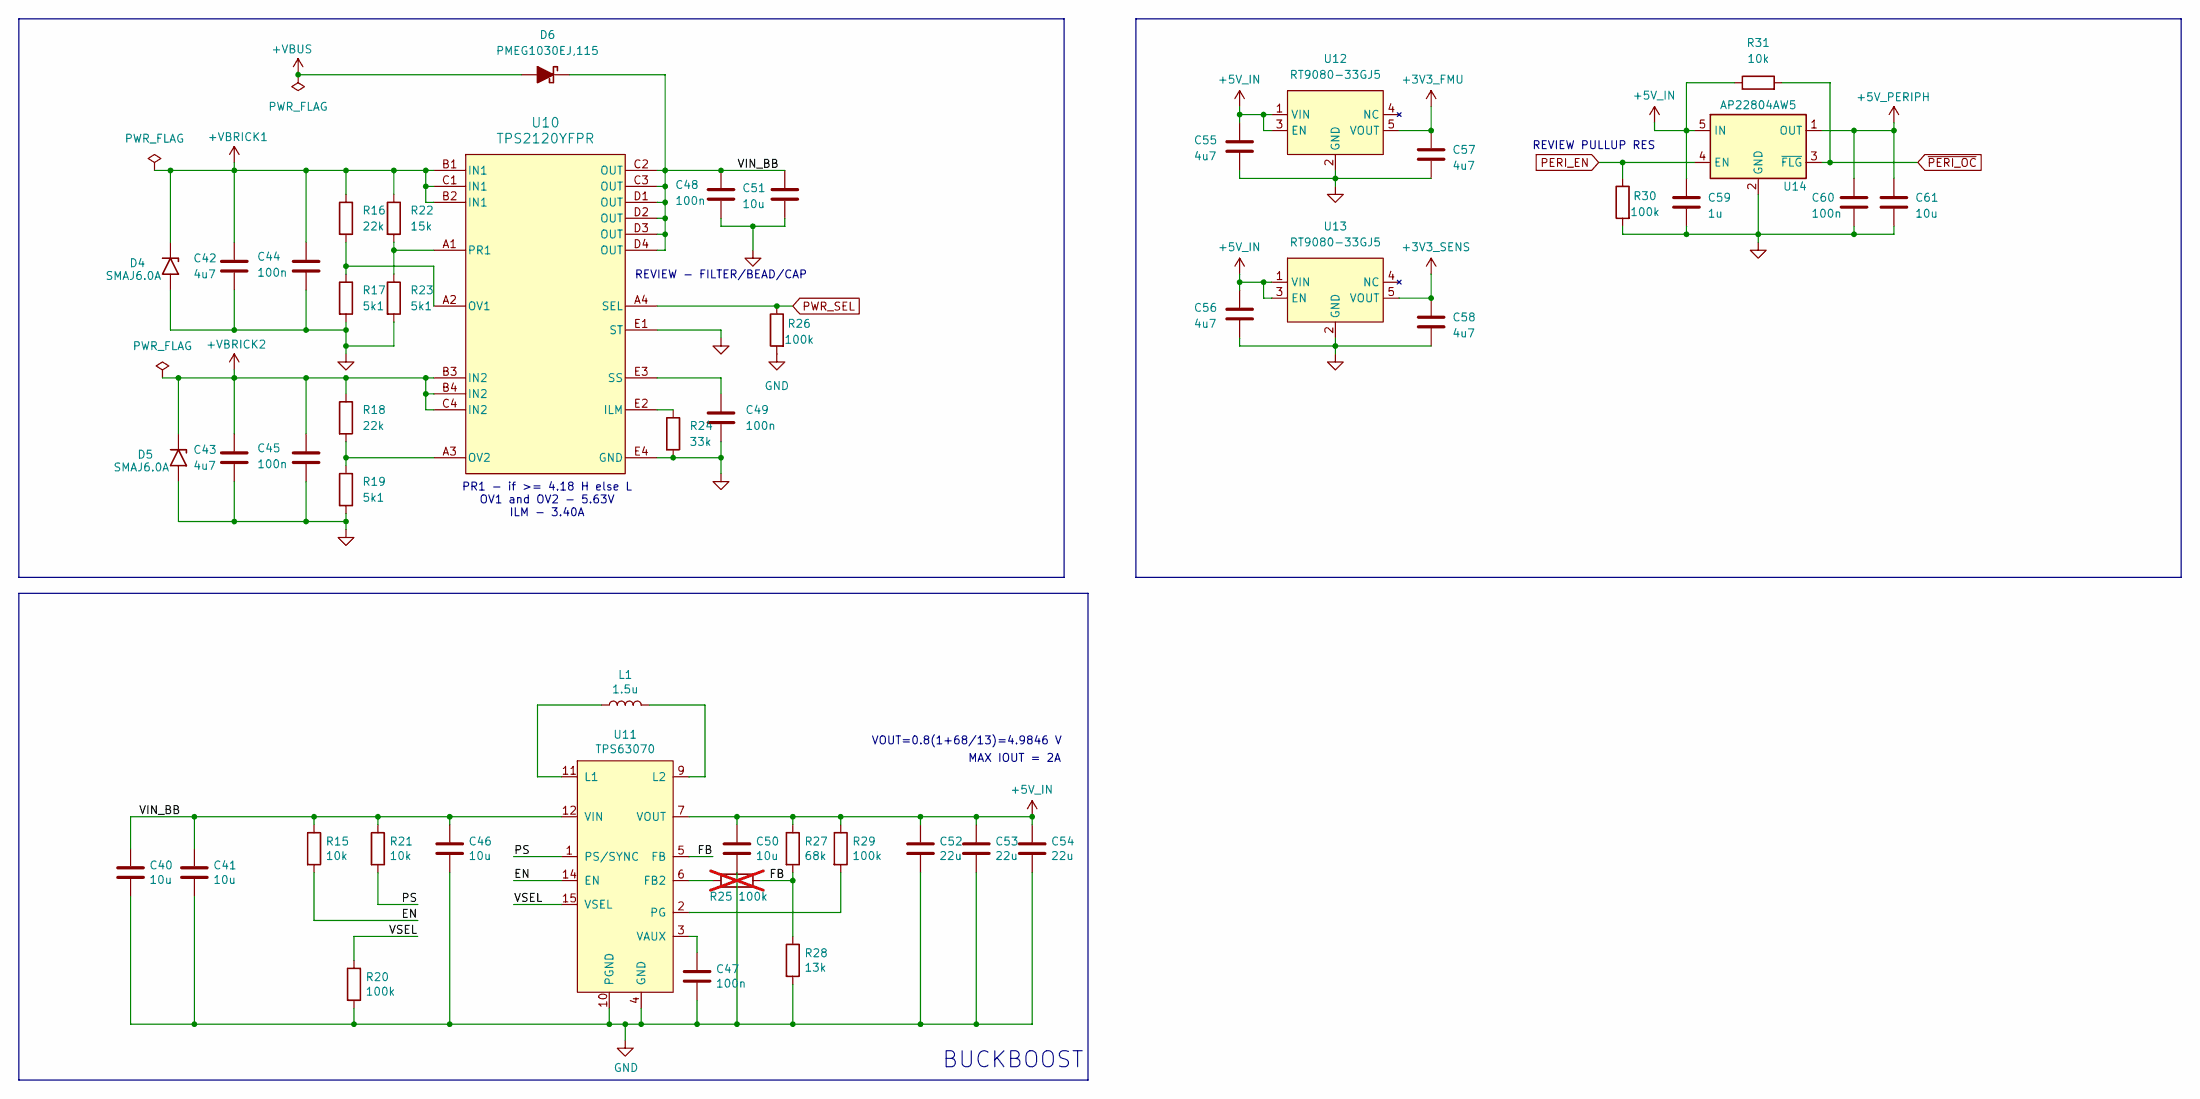
[picture p8: schematic power.kicad_sch, Svayamkriya Vibhava]

Parts:
C40, C41: 10u; C_0805_2012Metric; MPN CL21A106KAYNNNE; LCSC C15850
C42, C43, C55, C56, C57, C58: 4u7; C_0603_1608Metric; MPN CL10A475KO8NNNC; LCSC C19666
C44, C45, C48, C49, C60: 100n; C_0402_1005Metric; MPN CL05B104KB54PNC; LCSC C307331
C46, C50, C51, C61: 10u; C_0603_1608Metric; MPN CL10A106MA8NRNC; LCSC C96446
C47: 100n; C_0805_2012Metric; MPN CC0805KRX7R9BB104; LCSC C49678
C52, C53, C54: 22u; C_0805_2012Metric; MPN CL21A226MAQNNNE; LCSC C45783
C59: 1u; C_0603_1608Metric; MPN CL10A105KB8NNNC; LCSC C15849
D4, D5: SMAJ6.0A; D_SMA; MPN SMAJ6.0A; LCSC C353434
D6: PMEG1030EJ,115; D_SOD-323F; MPN PMEG1030EJ,115; LCSC C133633
L1: 1.5u; L_Coilcraft_XxL4020; MPN XGL4020-152MEC; LCSC C7417180
R15, R21: 10k; R_0805_2012Metric; MPN 0805W8F1002T5E; LCSC C17414
R16, R18: 22k; R_0402_1005Metric; MPN 0402WGF2202TCE; LCSC C25768
R17, R19, R23: 5k1; R_0402_1005Metric; MPN 0402WGF5101TCE; LCSC C25905
R20, R29: 100k; R_0805_2012Metric; MPN 0805W8F1003T5E; LCSC C149504
R22: 15k; R_0402_1005Metric; MPN 0402WGF1502TCE; LCSC C25756
R24: 33k; R_0402_1005Metric; MPN 0402WGF3302TCE; LCSC C25779
R25: 100k; R_0805_2012Metric; MPN 0805W8F1003T5E; LCSC C149504; not fitted
R26, R30: 100k; R_0402_1005Metric; MPN 0402WGF1003TCE; LCSC C25741
R27: 68k; R_0805_2012Metric; MPN 0805W8F6802T5E; LCSC C17801
R28: 13k; R_0805_2012Metric; MPN 0805W8F1302T5E; LCSC C17455
R31: 10k; R_0402_1005Metric; MPN 0402WGF1002TCE; LCSC C25744
U10: TPS2120YFPR; Texas_YFP0020_DSBGA-20_1.588x1.988mm_Layout4x5_P0.4mm; MPN TPS2120YFPR; LCSC C1850326
U11: TPS63070; VQFN-HR-15; MPN TPS63070RNMR; LCSC C109322
U12, U13: RT9080-33GJ5; TSOT-23-5; MPN RT9080-33GJ5; LCSC C841192
U14: AP22804AW5; SOT-23-5; MPN AP22804AW5-7; LCSC C3001659

Connections:
+3V3_FMU: C57.1, U12.5 (VOUT); also elsewhere on the board
+3V3_SENS: C58.1, U13.5 (VOUT); also elsewhere on the board
+5V_IN: C50.1, C52.1, C53.1, C54.1, C55.1, C56.1, C59.1, R27.1, R29.1, R31.1, U11.7 (VOUT), U12.1 (VIN), U12.3 (EN), U13.1 (VIN), U13.3 (EN), U14.5 (IN); also elsewhere on the board
+5V_PERIPH: C60.1, C61.1, U14.1 (OUT); also elsewhere on the board
+VBRICK1: C42.1, C44.1, D4.1 (A1), R16.1, R22.1, U10.B1 (IN1), U10.B2 (IN1), U10.C1 (IN1); also elsewhere on the board
+VBRICK2: C43.1, C45.1, D5.1 (A1), R18.1, U10.B3 (IN2), U10.B4 (IN2), U10.C4 (IN2); also elsewhere on the board
+VBUS: D6.2 (A); also elsewhere on the board
/Power/EN: R15.2, U11.14 (EN)
/Power/FB: R25.1, R27.2, R28.1, U11.5 (FB)
/Power/PS: R21.2, U11.1 (PS/SYNC)
/Power/VIN_BB: C40.1, C41.1, C46.1, C48.1, C51.1, D6.1 (K), R15.1, R21.1, U10.C2 (OUT), U10.C3 (OUT), U10.D1 (OUT), U10.D2 (OUT), U10.D3 (OUT), U10.D4 (OUT), U11.12 (VIN)
/Power/VSEL: R20.1, U11.15 (VSEL)
GND: C40.2, C41.2, C42.2, C43.2, C44.2, C45.2, C46.2, C47.1, C48.2, C49.2, C50.2, C51.2, C52.2, C53.2, C54.2, C55.2, C56.2, C57.2, C58.2, C59.2, C60.2, C61.2, D4.2 (A2), D5.2 (A2), R17.2, R19.2, R20.2, R23.2, R24.2, R26.2, R28.2, R30.2, U10.E1 (ST), U10.E4 (GND), U11.4 (GND), U11.10 (PGND), U12.2 (GND), U13.2 (GND), U14.2 (GND); also elsewhere on the board
unnamed: R24.1, U10.E2 (ILM)
unnamed: R16.2, R17.1, U10.A2 (OV1)
unnamed: R18.2, R19.1, U10.A3 (OV2)
unnamed: R22.2, R23.1, U10.A1 (PR1)
unnamed: C49.1, U10.E3 (SS)
unnamed: R25.2, U11.6 (FB2)
unnamed: L1.1, U11.11 (L1)
unnamed: L1.2, U11.9 (L2)
unnamed: R29.2, U11.2 (PG)
unnamed: C47.2, U11.3 (VAUX)
PERI_EN: R30.1, U14.4 (EN); also elsewhere on the board
PWR_SEL: R26.1, U10.A4 (SEL); also elsewhere on the board
~PERI_OC: R31.2, U14.3 (~FLG); also elsewhere on the board

Notes on the sheet:
MAX IOUT = 2A
BUCKBOOST
PR1 - if >= 4.18 H else L OV1 and OV2 - 5.63V ILM - 3.40A
VOUT =0.8(1+68/13)=4.9846 V 
REVIEW - FILTER/BEAD/CAP
REVIEW PULLUP RES

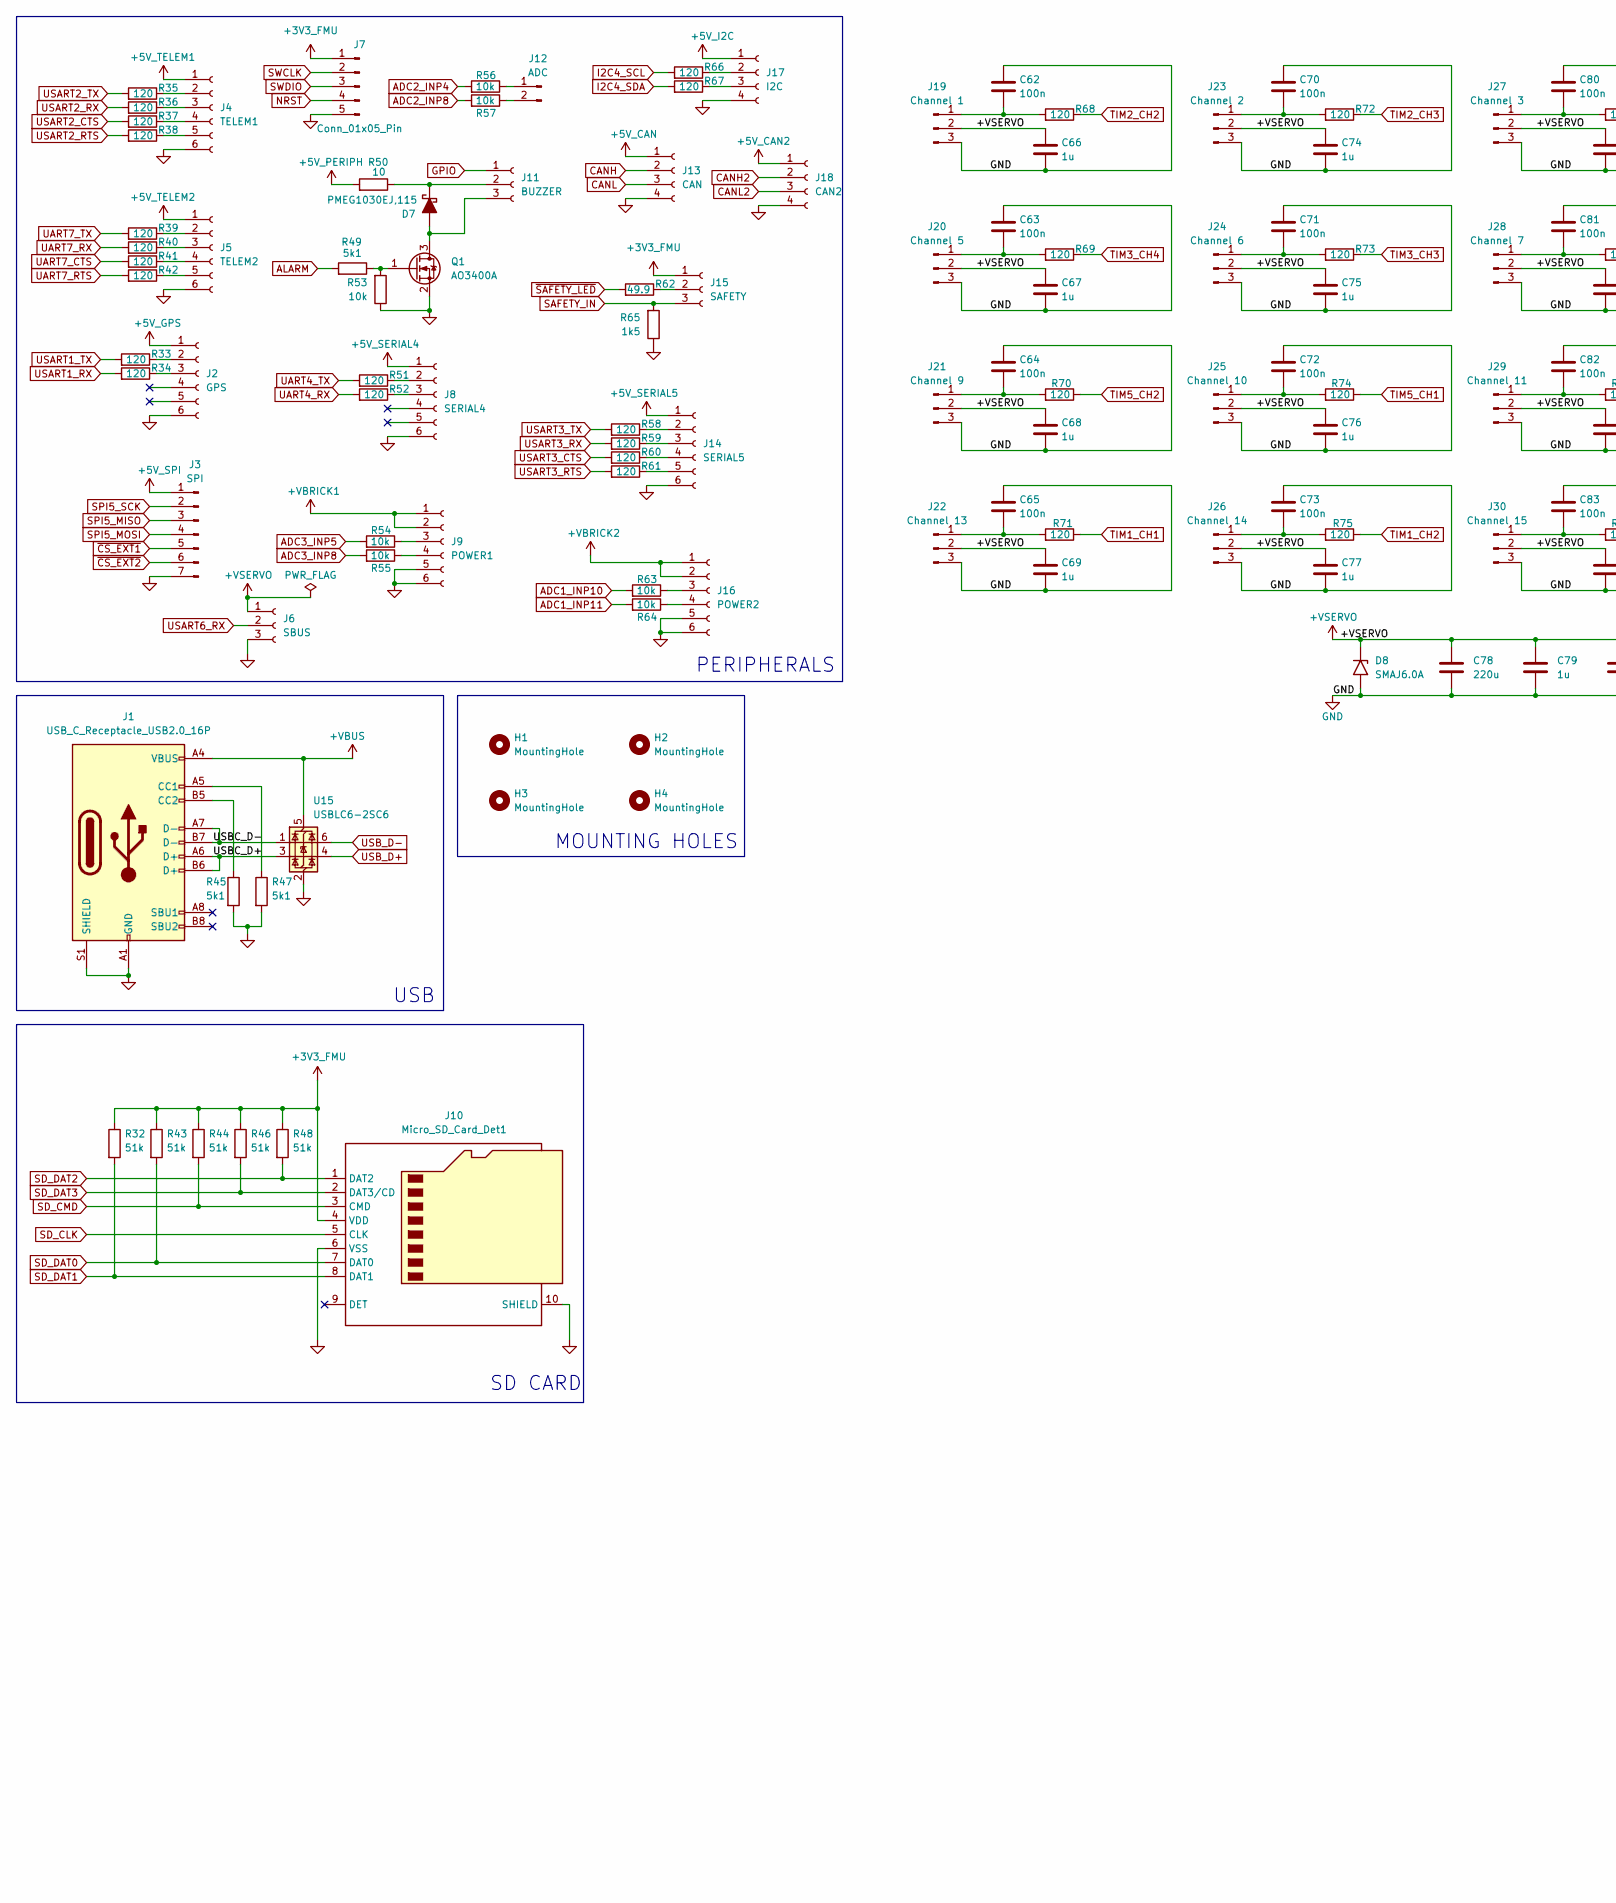
[picture p9: schematic connector.kicad_sch, Svayamkriya Vibhava, part in row 1, column 1]

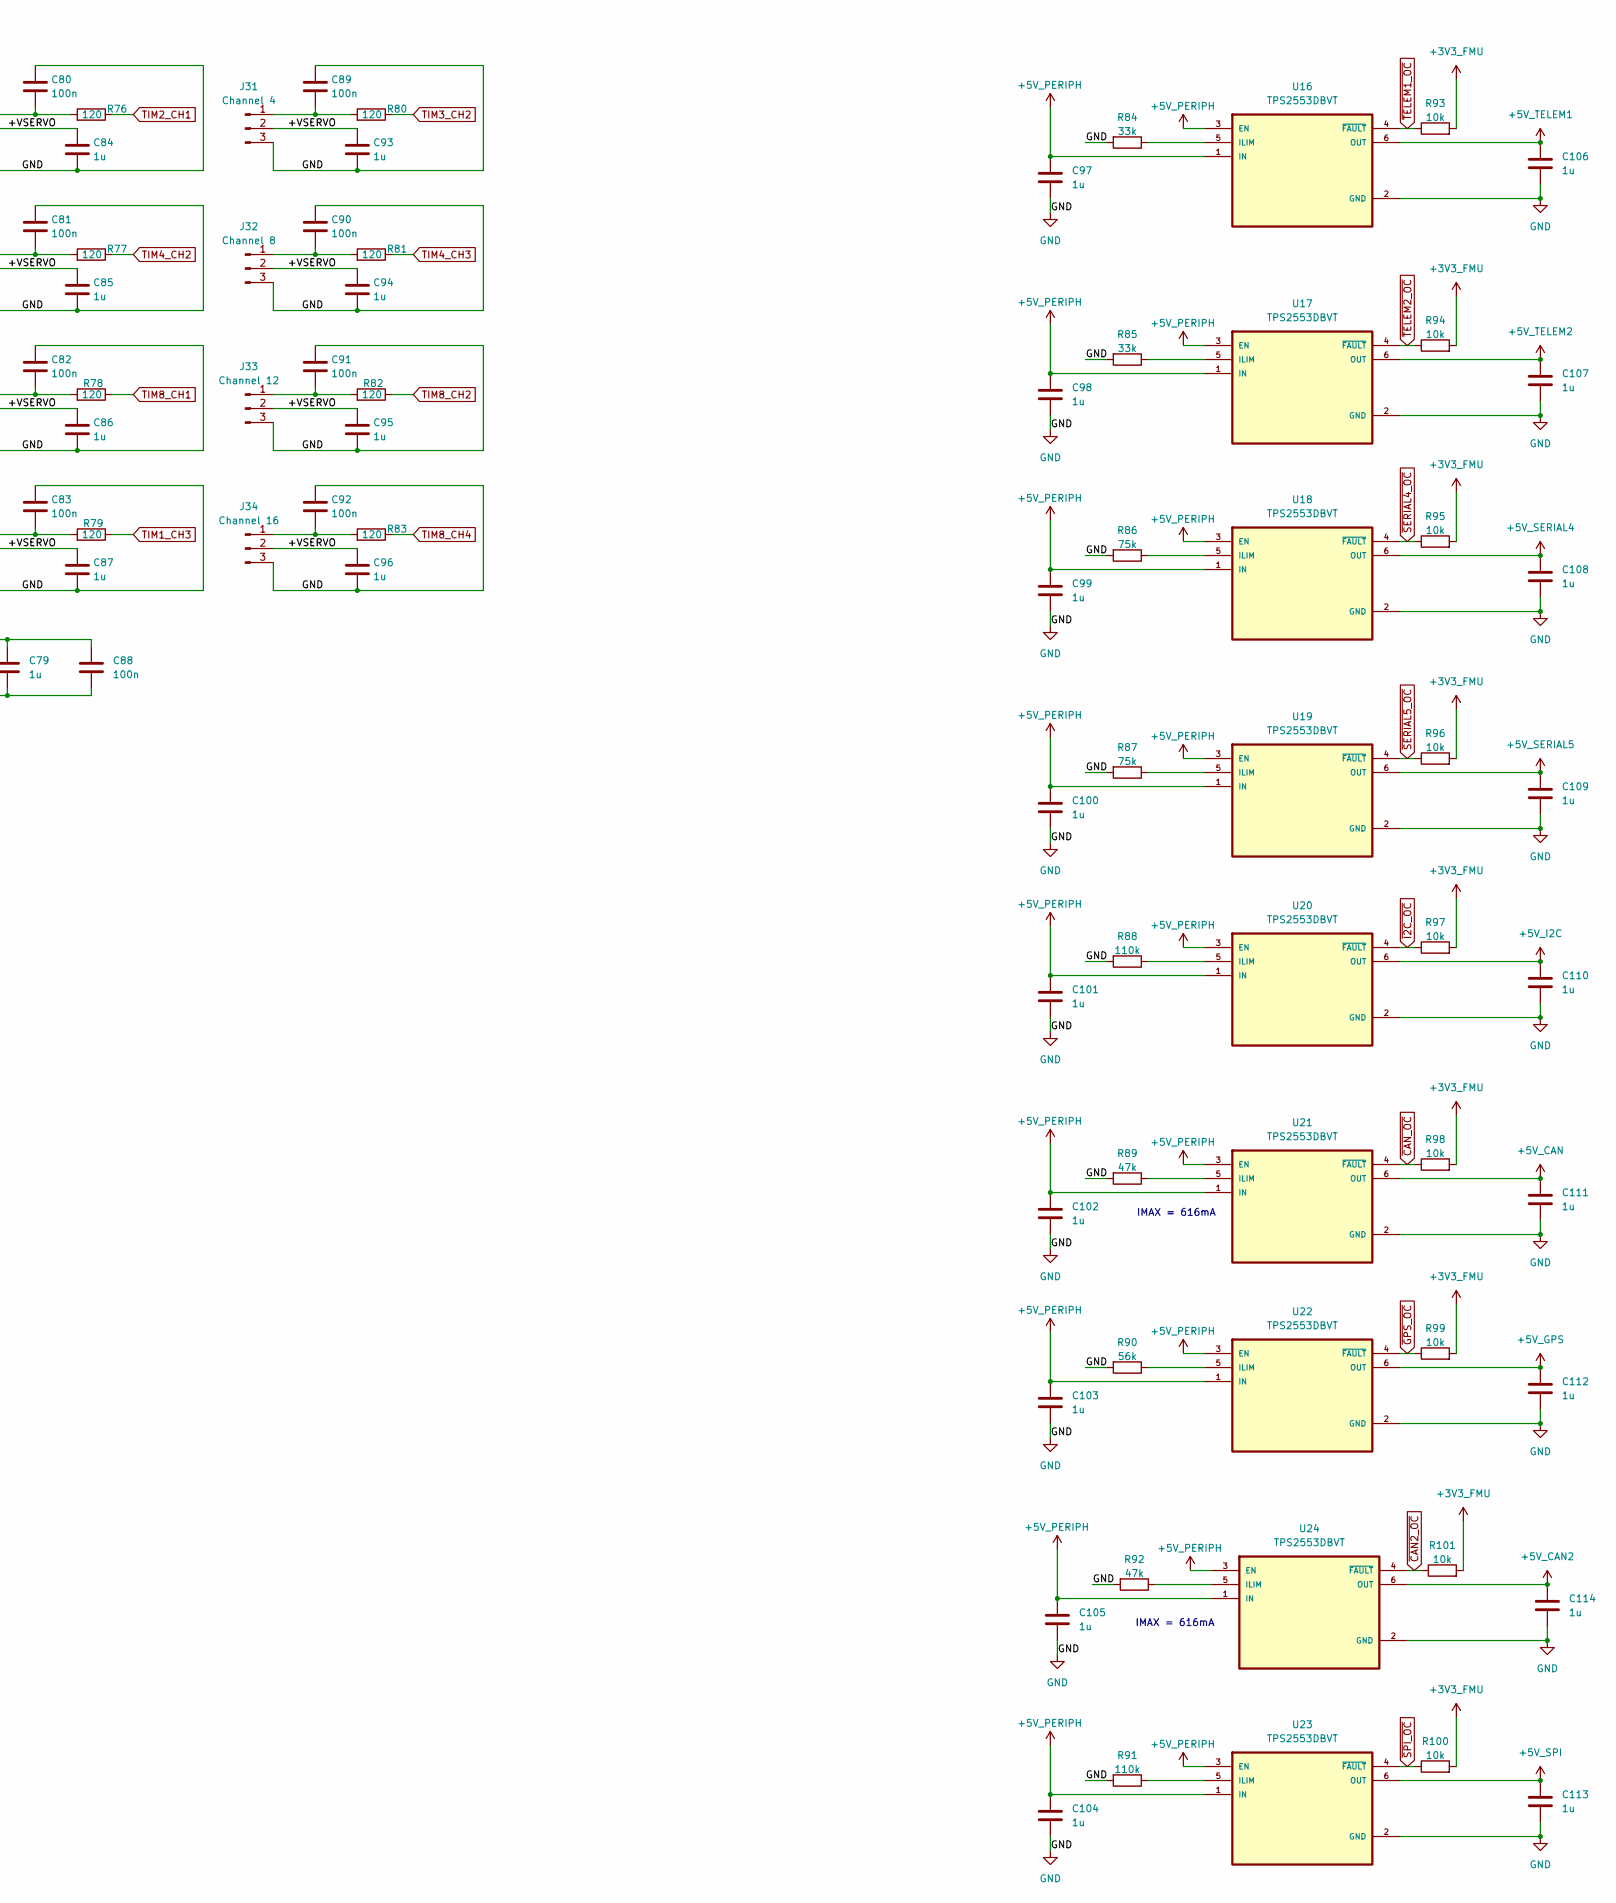
[picture p10: schematic connector.kicad_sch, Svayamkriya Vibhava, part in row 1, column 2]

Parts:
C62, C63, C64, C65, C70, C71, C72, C73, C80, C81, C82, C83, C88, C89, C90, C91, C92: 100n; C_0402_1005Metric
C66, C67, C68, C69, C74, C75, C76, C77, C79, C84, C85, C86, C87, C93, C94, C95, C96, C97, C98, C99, C100, C101, C102, C103, C104, C105, C106, C107, C108, C109, C110, C111, C112, C113, C114: 1u; C_0603_1608Metric
C78: 220u; CP_Elec_6.3x7.7
D7: PMEG1030EJ,115; D_SOD-323F; MPN PMEG1030EJ,115
D8: SMAJ6.0A; D_SMA
H1, H2, H3, H4: MountingHole; MountingHole_3.2mm_M3
J1: USB_C_Receptacle_USB2.0_16P; USB-C-SMD_TYPE-C16PIN; MPN TYPE-C16PIN
J2: GPS; JST_GH_BM06B-GHS-TBT_1x06-1MP_P1.25mm_Vertical
J3: SPI; JST_GH_BM07B-GHS-TBT_1x07-1MP_P1.25mm_Vertical
J4: TELEM1; JST_GH_BM06B-GHS-TBT_1x06-1MP_P1.25mm_Vertical
J5: TELEM2; JST_GH_BM06B-GHS-TBT_1x06-1MP_P1.25mm_Vertical
J6: SBUS; JST_GH_BM03B-GHS-TBT_1x03-1MP_P1.25mm_Vertical
J7: Conn_01x05_Pin; PinHeader_1x05_P2.54mm_Vertical
J8: SERIAL4; JST_GH_BM06B-GHS-TBT_1x06-1MP_P1.25mm_Vertical
J9: POWER1; JST_GH_BM06B-GHS-TBT_1x06-1MP_P1.25mm_Vertical
J10: Micro_SD_Card_Det1; 104031-0811_MOL; MPN 1040310811
J11: BUZZER; JST_GH_BM03B-GHS-TBT_1x03-1MP_P1.25mm_Vertical
J12: ADC; PinHeader_1x02_P2.54mm_Vertical
J13: CAN; JST_GH_BM04B-GHS-TBT_1x04-1MP_P1.25mm_Vertical
J14: SERIAL5; JST_GH_BM06B-GHS-TBT_1x06-1MP_P1.25mm_Vertical
J15: SAFETY; JST_GH_BM03B-GHS-TBT_1x03-1MP_P1.25mm_Vertical
J16: POWER2; JST_GH_BM06B-GHS-TBT_1x06-1MP_P1.25mm_Vertical
J17: I2C; JST_GH_BM04B-GHS-TBT_1x04-1MP_P1.25mm_Vertical
J18: CAN2; JST_GH_BM04B-GHS-TBT_1x04-1MP_P1.25mm_Vertical
J19: Channel 1; JST_XH_B3B-XH-A_1x03_P2.50mm_Vertical
J20: Channel 5; JST_XH_B3B-XH-A_1x03_P2.50mm_Vertical
J21: Channel 9; JST_XH_B3B-XH-A_1x03_P2.50mm_Vertical
J22: Channel 13; JST_XH_B3B-XH-A_1x03_P2.50mm_Vertical
J23: Channel 2; JST_XH_B3B-XH-A_1x03_P2.50mm_Vertical
J24: Channel 6; JST_XH_B3B-XH-A_1x03_P2.50mm_Vertical
J25: Channel 10; JST_XH_B3B-XH-A_1x03_P2.50mm_Vertical
J26: Channel 14; JST_XH_B3B-XH-A_1x03_P2.50mm_Vertical
J27: Channel 3; JST_XH_B3B-XH-A_1x03_P2.50mm_Vertical
J28: Channel 7; JST_XH_B3B-XH-A_1x03_P2.50mm_Vertical
J29: Channel 11; JST_XH_B3B-XH-A_1x03_P2.50mm_Vertical
J30: Channel 15; JST_XH_B3B-XH-A_1x03_P2.50mm_Vertical
J31: Channel 4; JST_XH_B3B-XH-A_1x03_P2.50mm_Vertical
J32: Channel 8; JST_XH_B3B-XH-A_1x03_P2.50mm_Vertical
J33: Channel 12; JST_XH_B3B-XH-A_1x03_P2.50mm_Vertical
J34: Channel 16; JST_XH_B3B-XH-A_1x03_P2.50mm_Vertical
Q1: AO3400A; SOT-23; MPN AO3400A
R32, R43, R44, R46, R48: 51k; R_0402_1005Metric; MPN 0402WGF5102TCE
R33, R34, R35, R36, R37, R38, R39, R40, R41, R42, R51, R52, R58, R59, R60, R61, R66, R67, R68, R69, R70, R71, R72, R73, R74, R75, R76, R77, R78, R79, R80, R81, R82, R83: 120; R_0402_1005Metric; MPN 0402WGF1200TCE
R45, R47, R49: 5k1; R_0402_1005Metric; MPN 0402WGF5101TCE
R50: 10; R_0402_1005Metric; MPN 0402WGF100JTCE
R53, R54, R55, R56, R57, R63, R64: 10k; R_0402_1005Metric; MPN 0402WGF1002TCE
R62: 49.9; R_0402_1005Metric; MPN 0402WGF499JTCE
R65: 1k5; R_0402_1005Metric; MPN 0402WGF1501TCE
R84, R85: 33k; R_0402_1005Metric
R86, R87: 75k; R_0402_1005Metric
R88, R91: 110k; R_0402_1005Metric
R89, R92: 47k; R_0402_1005Metric
R90: 56k; R_0402_1005Metric
R93, R94, R95, R96, R97, R98, R99, R100, R101: 10k; R_0402_1005Metric
U15: USBLC6-2SC6; SOT-23-6; MPN USBLC6-2SC6
U16, U17, U18, U19, U20, U21, U22, U23, U24: TPS2553DBVT; SOT95P280X145-6N

Connections:
+3V3_FMU: J7.1, J10.4 (VDD), J15.1, R32.1, R43.1, R44.1, R46.1, R48.1, R93.2, R94.2, R95.2, R96.2, R97.2, R98.2, R99.2, R100.2, R101.2; also elsewhere on the board
+5V_CAN: C111.1, J13.1, U21.6 (OUT)
+5V_CAN2: C114.1, J18.1, U24.6 (OUT)
+5V_GPS: C112.1, J2.1, U22.6 (OUT)
+5V_I2C: C110.1, J17.1, U20.6 (OUT)
+5V_PERIPH: C97.1, C98.1, C99.1, C100.1, C101.1, C102.1, C103.1, C104.1, C105.1, R50.2, U16.1 (IN), U16.3 (EN), U17.1 (IN), U17.3 (EN), U18.1 (IN), U18.3 (EN), U19.1 (IN), U19.3 (EN), U20.1 (IN), U20.3 (EN), U21.1 (IN), U21.3 (EN), U22.1 (IN), U22.3 (EN), U23.1 (IN), U23.3 (EN), U24.1 (IN), U24.3 (EN); also elsewhere on the board
+5V_SERIAL4: C108.1, J8.1, U18.6 (OUT)
+5V_SERIAL5: C109.1, J14.1, U19.6 (OUT)
+5V_SPI: C113.1, J3.1, U23.6 (OUT)
+5V_TELEM1: C106.1, J4.1, U16.6 (OUT)
+5V_TELEM2: C107.1, J5.1, U17.6 (OUT)
+VBRICK1: J9.1, J9.2; also elsewhere on the board
+VBRICK2: J16.1, J16.2; also elsewhere on the board
+VBUS: J1.A4 (VBUS), J1.A9 (VBUS), J1.B4 (VBUS), J1.B9 (VBUS), U15.5 (VBUS); also elsewhere on the board
+VSERVO: C66.1, C67.1, C68.1, C69.1, C74.1, C75.1, C76.1, C77.1, C78.1, C79.1, C84.1, C85.1, C86.1, C87.1, C88.1, C93.1, C94.1, C95.1, C96.1, D8.1 (A1), J6.1, J19.2, J20.2, J21.2, J22.2, J23.2, J24.2, J25.2, J26.2, J27.2, J28.2, J29.2, J30.2, J31.2, J32.2, J33.2, J34.2
/Connector/USBC_D+: J1.A6 (D+), J1.B6 (D+), U15.3 (I/O2)
/Connector/USBC_D-: J1.A7 (D-), J1.B7 (D-), U15.1 (I/O1)
ADC1_INP10: R63.2; also elsewhere on the board
ADC1_INP11: R64.2; also elsewhere on the board
ADC2_INP4: R56.2; also elsewhere on the board
ADC2_INP8: R57.2; also elsewhere on the board
ADC3_INP5: R54.2; also elsewhere on the board
ADC3_INP8: R55.2; also elsewhere on the board
ALARM: R49.2; also elsewhere on the board
CANH: J13.2; also elsewhere on the board
CANH2: J18.2; also elsewhere on the board
CANL: J13.3; also elsewhere on the board
CANL2: J18.3; also elsewhere on the board
GND: C62.1, C63.1, C64.1, C65.1, C66.2, C67.2, C68.2, C69.2, C70.1, C71.1, C72.1, C73.1, C74.2, C75.2, C76.2, C77.2, C78.2, C79.2, C80.1, C81.1, C82.1, C83.1, C84.2, C85.2, C86.2, C87.2, C88.2, C89.1, C90.1, C91.1, C92.1, C93.2, C94.2, C95.2, C96.2, C97.2, C98.2, C99.2, C100.2, C101.2, C102.2, C103.2, C104.2, C105.2, C106.2, C107.2, C108.2, C109.2, C110.2, C111.2, C112.2, C113.2, C114.2, D8.2 (A2), J1.A1 (GND), J1.A12 (GND), J1.B1 (GND), J1.B12 (GND), J1.S1 (SHIELD), J2.6, J3.7, J4.6, J5.6, J6.3, J7.5, J8.6, J9.5, J9.6, J10.6 (VSS), J10.10 (SHIELD), J13.4, J14.6, J16.5, J16.6, J17.4, J18.4, J19.3, J20.3, J21.3, J22.3, J23.3, J24.3, J25.3, J26.3, J27.3, J28.3, J29.3, J30.3, J31.3, J32.3, J33.3, J34.3, Q1.2 (S), R45.2, R47.2, R53.1, R65.1, R84.2, R85.2, R86.2, R87.2, R88.2, R89.2, R90.2, R91.2, R92.2, U15.2 (GND), U16.2 (GND), U17.2 (GND), U18.2 (GND), U19.2 (GND), U20.2 (GND), U21.2 (GND), U22.2 (GND), U23.2 (GND), U24.2 (GND); also elsewhere on the board
GPIO: J11.1; also elsewhere on the board
I2C4_SCL: R66.2; also elsewhere on the board
I2C4_SDA: R67.2; also elsewhere on the board
NRST: J7.4; also elsewhere on the board
unnamed: D7.2 (A), J11.3, Q1.3 (D)
unnamed: D7.1 (K), J11.2, R50.1
unnamed: J1.A5 (CC1), R47.1
unnamed: J1.B5 (CC2), R45.1
unnamed: J2.2, R33.1
unnamed: J2.3, R34.1
unnamed: J4.2, R35.1
unnamed: J4.3, R36.1
unnamed: J4.4, R37.1
unnamed: J4.5, R38.1
unnamed: J5.2, R39.1
unnamed: J5.3, R40.1
unnamed: J5.4, R41.1
unnamed: J5.5, R42.1
unnamed: J8.2, R51.1
unnamed: J8.3, R52.1
unnamed: J9.3, R54.1
unnamed: J9.4, R55.1
unnamed: J12.1, R56.1
unnamed: J12.2, R57.1
unnamed: J14.2, R58.1
unnamed: J14.3, R59.1
unnamed: J14.4, R60.1
unnamed: J14.5, R61.1
unnamed: J15.2, R62.1
unnamed: J16.3, R63.1
unnamed: J16.4, R64.1
unnamed: J17.2, R66.1
unnamed: J17.3, R67.1
unnamed: C62.2, J19.1, R68.2
unnamed: C63.2, J20.1, R69.2
unnamed: C64.2, J21.1, R70.2
unnamed: C65.2, J22.1, R71.2
unnamed: C70.2, J23.1, R72.2
unnamed: C71.2, J24.1, R73.2
unnamed: C72.2, J25.1, R74.2
unnamed: C73.2, J26.1, R75.2
unnamed: C80.2, J27.1, R76.2
unnamed: C81.2, J28.1, R77.2
unnamed: C82.2, J29.1, R78.2
unnamed: C83.2, J30.1, R79.2
unnamed: C89.2, J31.1, R80.2
unnamed: C90.2, J32.1, R81.2
unnamed: C91.2, J33.1, R82.2
unnamed: C92.2, J34.1, R83.2
unnamed: Q1.1 (G), R49.1, R53.2
unnamed: R84.1, U16.5 (ILIM)
unnamed: R85.1, U17.5 (ILIM)
unnamed: R86.1, U18.5 (ILIM)
unnamed: R87.1, U19.5 (ILIM)
unnamed: R88.1, U20.5 (ILIM)
unnamed: R89.1, U21.5 (ILIM)
unnamed: R90.1, U22.5 (ILIM)
unnamed: R91.1, U23.5 (ILIM)
unnamed: R92.1, U24.5 (ILIM)
SAFETY_IN: J15.3, R65.2; also elsewhere on the board
SD_CLK: J10.5 (CLK); also elsewhere on the board
SD_CMD: J10.3 (CMD), R44.2; also elsewhere on the board
SD_DAT0: J10.7 (DAT0), R43.2; also elsewhere on the board
SD_DAT1: J10.8 (DAT1), R32.2; also elsewhere on the board
SD_DAT2: J10.1 (DAT2), R48.2; also elsewhere on the board
SD_DAT3: J10.2 (DAT3/CD), R46.2; also elsewhere on the board
SPI5_MISO: J3.3; also elsewhere on the board
SPI5_MOSI: J3.4; also elsewhere on the board
SPI5_SCK: J3.2; also elsewhere on the board
SWCLK: J7.2; also elsewhere on the board
SWDIO: J7.3; also elsewhere on the board
TIM1_CH1: R71.1; also elsewhere on the board
TIM1_CH2: R75.1; also elsewhere on the board
TIM1_CH3: R79.1; also elsewhere on the board
TIM2_CH1: R76.1; also elsewhere on the board
TIM2_CH2: R68.1; also elsewhere on the board
TIM2_CH3: R72.1; also elsewhere on the board
TIM3_CH2: R80.1; also elsewhere on the board
TIM3_CH3: R73.1; also elsewhere on the board
TIM3_CH4: R69.1; also elsewhere on the board
TIM4_CH2: R77.1; also elsewhere on the board
TIM4_CH3: R81.1; also elsewhere on the board
TIM5_CH1: R74.1; also elsewhere on the board
TIM5_CH2: R70.1; also elsewhere on the board
TIM8_CH1: R78.1; also elsewhere on the board
TIM8_CH2: R82.1; also elsewhere on the board
TIM8_CH4: R83.1; also elsewhere on the board
UART4_RX: R52.2; also elsewhere on the board
UART4_TX: R51.2; also elsewhere on the board
UART7_CTS: R41.2; also elsewhere on the board
UART7_RTS: R42.2; also elsewhere on the board
UART7_RX: R40.2; also elsewhere on the board
UART7_TX: R39.2; also elsewhere on the board
USART1_RX: R34.2; also elsewhere on the board
USART1_TX: R33.2; also elsewhere on the board
USART2_CTS: R37.2; also elsewhere on the board
USART2_RTS: R38.2; also elsewhere on the board
USART2_RX: R36.2; also elsewhere on the board
USART2_TX: R35.2; also elsewhere on the board
USART3_CTS: R60.2; also elsewhere on the board
USART3_RTS: R61.2; also elsewhere on the board
USART3_RX: R59.2; also elsewhere on the board
USART3_TX: R58.2; also elsewhere on the board
USART6_RX: J6.2; also elsewhere on the board
USB_D+: U15.4 (I/O2); also elsewhere on the board
USB_D-: U15.6 (I/O1); also elsewhere on the board
~CAN2_OC: R101.1, U24.4 (~FAULT); also elsewhere on the board
~CAN_OC: R98.1, U21.4 (~FAULT); also elsewhere on the board
~CS_EXT1: J3.5; also elsewhere on the board
~CS_EXT2: J3.6; also elsewhere on the board
~GPS_OC: R99.1, U22.4 (~FAULT); also elsewhere on the board
~I2C_OC: R97.1, U20.4 (~FAULT); also elsewhere on the board
~SAFETY_LED: R62.2; also elsewhere on the board
~SERIAL4_OC: R95.1, U18.4 (~FAULT); also elsewhere on the board
~SERIAL5_OC: R96.1, U19.4 (~FAULT); also elsewhere on the board
~SPI_OC: R100.1, U23.4 (~FAULT); also elsewhere on the board
~TELEM1_OC: R93.1, U16.4 (~FAULT); also elsewhere on the board
~TELEM2_OC: R94.1, U17.4 (~FAULT); also elsewhere on the board

Notes on the sheet:
MOUNTING HOLES
IMAX = 616mA
PERIPHERALS
SD CARD
USB

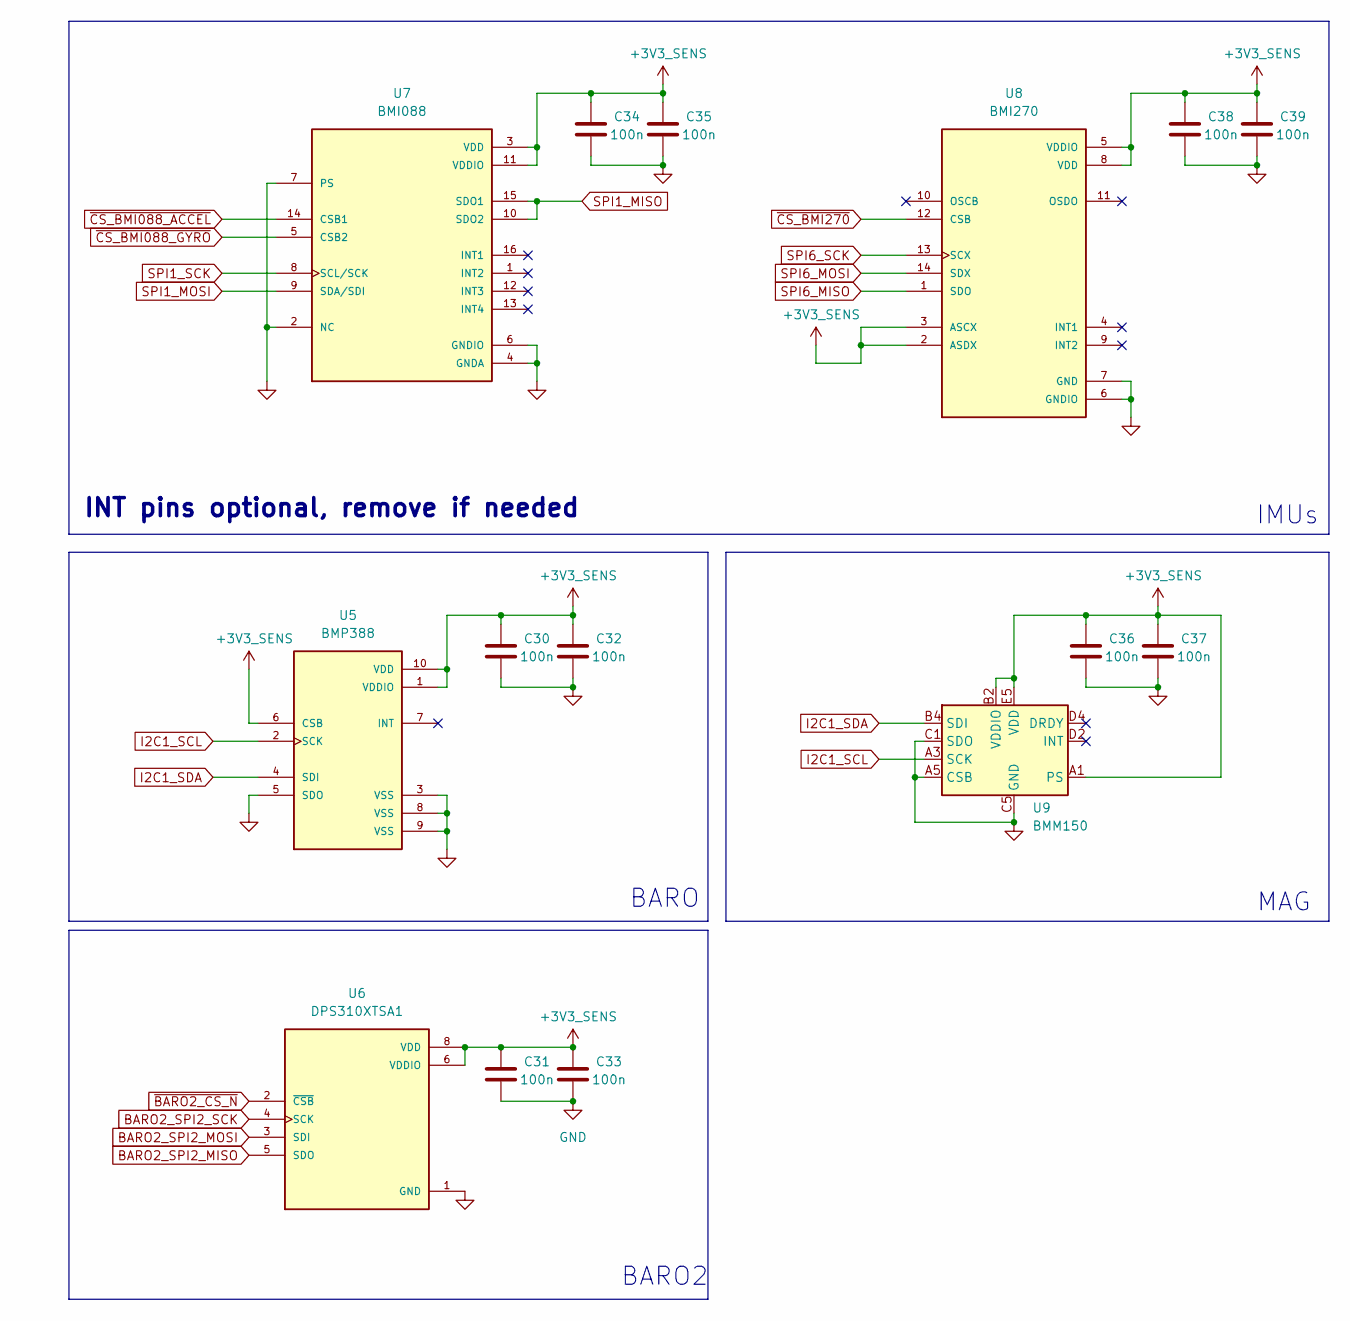
[picture p11: schematic sensor.kicad_sch, Svayamkriya Vibhava]

Parts:
C30, C31, C32, C33, C34, C35, C36, C37, C38, C39: 100n; C_0402_1005Metric; MPN CL05B104KB54PNC
U5: BMP388; XDCR_BMP388; PARTREV 1.1
U6: DPS310XTSA1; XDCR_DPS310XTSA1
U7: BMI088; PQFN50P450X300X100-16N; MPN BMI088
U8: BMI270; XDCR_BMI270; MPN BMI270
U9: BMM150; WLCSP-12_1.56x1.56mm_P0.4mm; MPN BMM150

Connections:
+3V3_SENS: C30.1, C31.1, C32.1, C33.1, C34.1, C35.1, C36.1, C37.1, C38.1, C39.1, U5.1 (VDDIO), U5.6 (CSB), U5.10 (VDD), U6.6 (VDDIO), U6.8 (VDD), U7.3 (VDD), U7.11 (VDDIO), U8.2 (ASDX), U8.3 (ASCX), U8.5 (VDDIO), U8.8 (VDD), U9.A1 (PS), U9.B2 (VDDIO), U9.E5 (VDD); also elsewhere on the board
BARO2_SPI2_MISO: U6.5 (SDO); also elsewhere on the board
BARO2_SPI2_MOSI: U6.3 (SDI); also elsewhere on the board
BARO2_SPI2_SCK: U6.4 (SCK); also elsewhere on the board
GND: C30.2, C31.2, C32.2, C33.2, C34.2, C35.2, C36.2, C37.2, C38.2, C39.2, U5.3 (VSS), U5.5 (SDO), U5.8 (VSS), U5.9 (VSS), U6.1 (GND), U6.7 (GND), U7.2 (NC), U7.4 (GNDA), U7.6 (GNDIO), U7.7 (PS), U8.6 (GNDIO), U8.7 (GND), U9.A5 (CSB), U9.C1 (SDO), U9.C5 (GND), U9.E1 (GND), U9.E3 (GND); also elsewhere on the board
I2C1_SCL: U5.2 (SCK), U9.A3 (SCK); also elsewhere on the board
I2C1_SDA: U5.4 (SDI), U9.B4 (SDI); also elsewhere on the board
SPI1_MISO: U7.10 (SDO2), U7.15 (SDO1); also elsewhere on the board
SPI1_MOSI: U7.9 (SDA/SDI); also elsewhere on the board
SPI1_SCK: U7.8 (SCL/SCK); also elsewhere on the board
SPI6_MISO: U8.1 (SDO); also elsewhere on the board
SPI6_MOSI: U8.14 (SDX); also elsewhere on the board
SPI6_SCK: U8.13 (SCX); also elsewhere on the board
~BARO2_CS_N: U6.2 (~CSB); also elsewhere on the board
~CS_BMI088_ACCEL: U7.14 (CSB1); also elsewhere on the board
~CS_BMI088_GYRO: U7.5 (CSB2); also elsewhere on the board
~CS_BMI270: U8.12 (CSB); also elsewhere on the board

Notes on the sheet:
MAG
BARO2
IMUs
BARO
INT pins optional, remove if needed
