si-nalsal/pcb-mantis/SvayamV3_IIK.kicad_pcb

## KiCad design SvayamV3_IIK.kicad_pcb (continued)

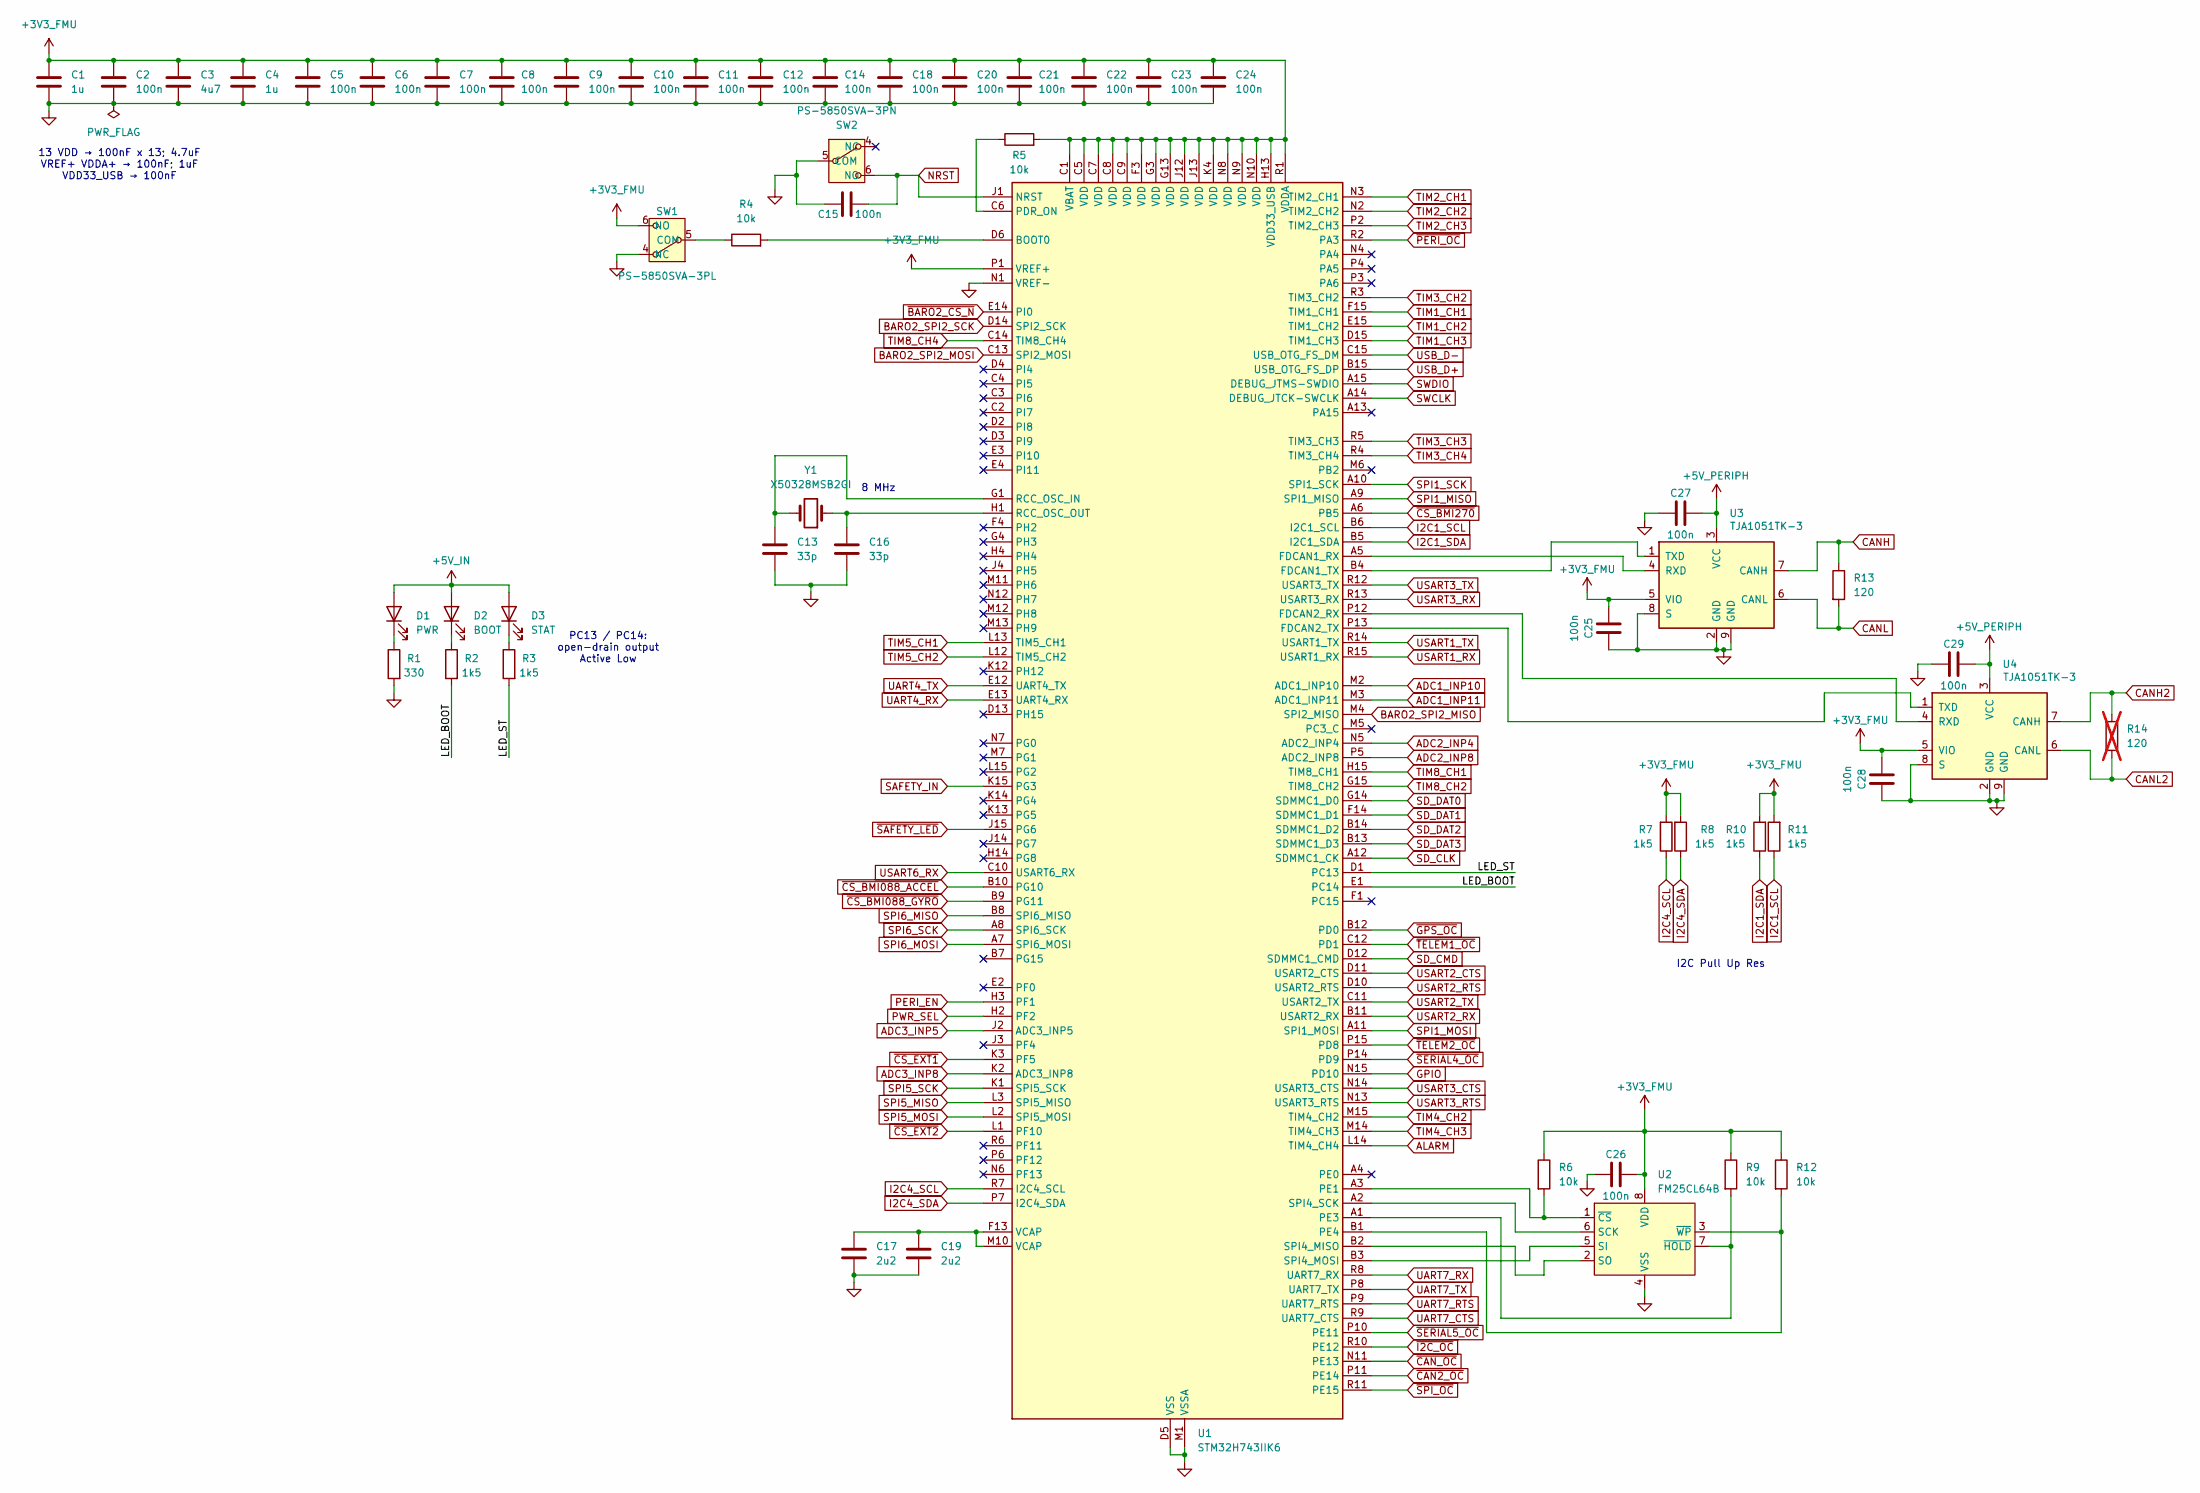
[picture p12: schematic microcontroller.kicad_sch, Svayamkriya Vibhava]

Parts:
C1, C4: 1u; C_0603_1608Metric; MPN CL10A105KB8NNNC
C2, C5, C6, C7, C8, C9, C10, C11, C12, C14, C15, C18, C20, C21, C22, C23, C24, C25, C26, C27, C28, C29: 100n; C_0402_1005Metric; MPN CL05B104KB54PNC
C3: 4u7; C_0603_1608Metric; MPN CL10A475KO8NNNC
C13, C16: 33p; C_0402_1005Metric; MPN 0402CG330J500NT
C17, C19: 2u2; C_0603_1608Metric; MPN CL10A225KO8NNNC
D1: PWR; D_0603_1608Metric; MPN NCD0603R1
D2: BOOT; D_0603_1608Metric; MPN NCD0603R1
D3: STAT; D_0603_1608Metric; MPN NCD0603R1
R1: 330; R_0402_1005Metric; MPN 0402WGF3300TCE
R2, R3, R7, R8, R10, R11: 1k5; R_0402_1005Metric; MPN 0402WGF1501TCE
R4, R5, R6, R9, R12: 10k; R_0402_1005Metric; MPN 0402WGF1002TCE
R13: 120; R_0402_1005Metric; MPN 0402WGF1200TCE
R14: 120; R_0402_1005Metric; MPN 0402WGF1200TCE; not fitted
SW1: PS-5850SVA-3PL; SW-SMD_G-SWITCH_PS-5850SVX-3PL; MPN PS-5850SVA-3PL; LCSC C5155594
SW2: PS-5850SVA-3PN; SW-SMD_G-SWITCH_PS-5850SVX-3PL; MPN PS-5850SVA-3PN; LCSC C5155595
U1: STM32H743IIK6; UFBGA-201_10x10mm_Layout15x15_P0.65mm; MPN STM32H743IIK6
U2: FM25CL64B; SOIC-8_3.9x4.9mm_P1.27mm; MPN FM25CL64B-GTR
U3, U4: TJA1051TK-3; DFN-8-1EP_3x3mm_P0.65mm_EP1.55x2.4mm; MPN TJA1051TK/3,118
Y1: X50328MSB2GI; Crystal_SMD_5032-2Pin_5.0x3.2mm; MPN X50328MSB2GI

Connections:
+3V3_FMU: C1.1, C2.1, C3.1, C4.1, C5.1, C6.1, C7.1, C8.1, C9.1, C10.1, C11.1, C12.1, C14.1, C18.1, C20.1, C21.1, C22.1, C23.1, C24.1, C25.1, C26.2, C28.1, R5.2, R6.1, R7.2, R8.2, R9.1, R10.2, R11.2, R12.1, SW1.6 (NO), U1.C1 (VBAT), U1.C5 (VDD), U1.C7 (VDD), U1.C8 (VDD), U1.C9 (VDD), U1.F3 (VDD), U1.G3 (VDD), U1.G13 (VDD), U1.H13 (VDD33_USB), U1.J12 (VDD), U1.J13 (VDD), U1.K4 (VDD), U1.N8 (VDD), U1.N9 (VDD), U1.N10 (VDD), U1.P1 (VREF+), U1.R1 (VDDA), U2.8 (VDD), U3.5 (VIO), U4.5 (VIO); also elsewhere on the board
+5V_IN: D1.2 (A), D2.2 (A), D3.2 (A); also elsewhere on the board
+5V_PERIPH: C27.2, C29.2, U3.3 (VCC), U4.3 (VCC); also elsewhere on the board
/Microcontroller/LED_BOOT: R2.2, U1.E1 (PC14)
/Microcontroller/LED_ST: R3.2, U1.D1 (PC13)
ADC1_INP10: U1.M2 (ADC1_INP10); also elsewhere on the board
ADC1_INP11: U1.M3 (ADC1_INP11); also elsewhere on the board
ADC2_INP4: U1.N5 (ADC2_INP4); also elsewhere on the board
ADC2_INP8: U1.P5 (ADC2_INP8); also elsewhere on the board
ADC3_INP5: U1.J2 (ADC3_INP5); also elsewhere on the board
ADC3_INP8: U1.K2 (ADC3_INP8); also elsewhere on the board
ALARM: U1.L14 (TIM4_CH4); also elsewhere on the board
BARO2_SPI2_MISO: U1.M4 (SPI2_MISO); also elsewhere on the board
BARO2_SPI2_MOSI: U1.C13 (SPI2_MOSI); also elsewhere on the board
BARO2_SPI2_SCK: U1.D14 (SPI2_SCK); also elsewhere on the board
CANH: R13.1, U3.7 (CANH); also elsewhere on the board
CANH2: R14.1, U4.7 (CANH); also elsewhere on the board
CANL: R13.2, U3.6 (CANL); also elsewhere on the board
CANL2: R14.2, U4.6 (CANL); also elsewhere on the board
GND: C1.2, C2.2, C3.2, C4.2, C5.2, C6.2, C7.2, C8.2, C9.2, C10.2, C11.2, C12.2, C13.2, C14.2, C15.1, C16.2, C17.2, C18.2, C19.2, C20.2, C21.2, C22.2, C23.2, C24.2, C25.2, C26.1, C27.1, C28.2, C29.1, R1.2, SW1.4 (NC), SW2.5 (COM), U1.D5 (VSS), U1.D7 (VSS), U1.D8 (VSS), U1.D9 (VSS), U1.F2 (VSS), U1.F6 (VSS), U1.F7 (VSS), U1.F8 (VSS), U1.F9 (VSS), U1.F10 (VSS), U1.F12 (VSS), U1.G2 (VSS), U1.G6 (VSS), U1.G7 (VSS), U1.G8 (VSS), U1.G9 (VSS), U1.G10 (VSS), U1.G12 (VSS), U1.H6 (VSS), U1.H7 (VSS), U1.H8 (VSS), U1.H9 (VSS), U1.H10 (VSS), U1.H12 (VSS), U1.J6 (VSS), U1.J7 (VSS), U1.J8 (VSS), U1.J9 (VSS), U1.J10 (VSS), U1.K6 (VSS), U1.K7 (VSS), U1.K8 (VSS), U1.K9 (VSS), U1.K10 (VSS), U1.L4 (VSS), U1.M1 (VSSA), U1.M8 (VSS), U1.M9 (VSS), U1.N1 (VREF-), U2.4 (VSS), U3.2 (GND), U3.8 (S), U3.9 (GND), U4.2 (GND), U4.8 (S), U4.9 (GND); also elsewhere on the board
GPIO: U1.N15 (PD10); also elsewhere on the board
I2C1_SCL: R11.1, U1.B6 (I2C1_SCL); also elsewhere on the board
I2C1_SDA: R10.1, U1.B5 (I2C1_SDA); also elsewhere on the board
I2C4_SCL: R7.1, U1.R7 (I2C4_SCL); also elsewhere on the board
I2C4_SDA: R8.1, U1.P7 (I2C4_SDA); also elsewhere on the board
NRST: C15.2, SW2.6 (NO), U1.J1 (NRST); also elsewhere on the board
unnamed: C17.1, C19.1, U1.F13 (VCAP), U1.M10 (VCAP)
unnamed: D1.1 (K), R1.1
unnamed: D2.1 (K), R2.1
unnamed: D3.1 (K), R3.1
unnamed: R4.1, SW1.5 (COM)
unnamed: R4.2, U1.D6 (BOOT0)
unnamed: U1.A5 (FDCAN1_RX), U3.4 (RXD)
unnamed: U1.B4 (FDCAN1_TX), U3.1 (TXD)
unnamed: U1.P12 (FDCAN2_RX), U4.4 (RXD)
unnamed: U1.P13 (FDCAN2_TX), U4.1 (TXD)
unnamed: R5.1, U1.C6 (PDR_ON)
unnamed: R6.2, U1.A3 (PE1), U2.1 (~CS)
unnamed: U1.A2 (SPI4_SCK), U2.6 (SCK)
unnamed: R9.2, U1.A1 (PE3), U2.7 (~HOLD)
unnamed: R12.2, U1.B1 (PE4), U2.3 (~WP)
unnamed: U1.B2 (SPI4_MISO), U2.2 (SO)
unnamed: U1.B3 (SPI4_MOSI), U2.5 (SI)
unnamed: C13.1, U1.G1 (RCC_OSC_IN), Y1.2
unnamed: C16.1, U1.H1 (RCC_OSC_OUT), Y1.1
PERI_EN: U1.H3 (PF1); also elsewhere on the board
PWR_SEL: U1.H2 (PF2); also elsewhere on the board
SAFETY_IN: U1.K15 (PG3); also elsewhere on the board
SD_CLK: U1.A12 (SDMMC1_CK); also elsewhere on the board
SD_CMD: U1.D12 (SDMMC1_CMD); also elsewhere on the board
SD_DAT0: U1.G14 (SDMMC1_D0); also elsewhere on the board
SD_DAT1: U1.F14 (SDMMC1_D1); also elsewhere on the board
SD_DAT2: U1.B14 (SDMMC1_D2); also elsewhere on the board
SD_DAT3: U1.B13 (SDMMC1_D3); also elsewhere on the board
SPI1_MISO: U1.A9 (SPI1_MISO); also elsewhere on the board
SPI1_MOSI: U1.A11 (SPI1_MOSI); also elsewhere on the board
SPI1_SCK: U1.A10 (SPI1_SCK); also elsewhere on the board
SPI5_MISO: U1.L3 (SPI5_MISO); also elsewhere on the board
SPI5_MOSI: U1.L2 (SPI5_MOSI); also elsewhere on the board
SPI5_SCK: U1.K1 (SPI5_SCK); also elsewhere on the board
SPI6_MISO: U1.B8 (SPI6_MISO); also elsewhere on the board
SPI6_MOSI: U1.A7 (SPI6_MOSI); also elsewhere on the board
SPI6_SCK: U1.A8 (SPI6_SCK); also elsewhere on the board
SWCLK: U1.A14 (DEBUG_JTCK-SWCLK); also elsewhere on the board
SWDIO: U1.A15 (DEBUG_JTMS-SWDIO); also elsewhere on the board
TIM1_CH1: U1.F15 (TIM1_CH1); also elsewhere on the board
TIM1_CH2: U1.E15 (TIM1_CH2); also elsewhere on the board
TIM1_CH3: U1.D15 (TIM1_CH3); also elsewhere on the board
TIM2_CH1: U1.N3 (TIM2_CH1); also elsewhere on the board
TIM2_CH2: U1.N2 (TIM2_CH2); also elsewhere on the board
TIM2_CH3: U1.P2 (TIM2_CH3); also elsewhere on the board
TIM3_CH2: U1.R3 (TIM3_CH2); also elsewhere on the board
TIM3_CH3: U1.R5 (TIM3_CH3); also elsewhere on the board
TIM3_CH4: U1.R4 (TIM3_CH4); also elsewhere on the board
TIM4_CH2: U1.M15 (TIM4_CH2); also elsewhere on the board
TIM4_CH3: U1.M14 (TIM4_CH3); also elsewhere on the board
TIM5_CH1: U1.L13 (TIM5_CH1); also elsewhere on the board
TIM5_CH2: U1.L12 (TIM5_CH2); also elsewhere on the board
TIM8_CH1: U1.H15 (TIM8_CH1); also elsewhere on the board
TIM8_CH2: U1.G15 (TIM8_CH2); also elsewhere on the board
TIM8_CH4: U1.C14 (TIM8_CH4); also elsewhere on the board
UART4_RX: U1.E13 (UART4_RX); also elsewhere on the board
UART4_TX: U1.E12 (UART4_TX); also elsewhere on the board
UART7_CTS: U1.R9 (UART7_CTS); also elsewhere on the board
UART7_RTS: U1.P9 (UART7_RTS); also elsewhere on the board
UART7_RX: U1.R8 (UART7_RX); also elsewhere on the board
UART7_TX: U1.P8 (UART7_TX); also elsewhere on the board
USART1_RX: U1.R15 (USART1_RX); also elsewhere on the board
USART1_TX: U1.R14 (USART1_TX); also elsewhere on the board
USART2_CTS: U1.D11 (USART2_CTS); also elsewhere on the board
USART2_RTS: U1.D10 (USART2_RTS); also elsewhere on the board
USART2_RX: U1.B11 (USART2_RX); also elsewhere on the board
USART2_TX: U1.C11 (USART2_TX); also elsewhere on the board
USART3_CTS: U1.N14 (USART3_CTS); also elsewhere on the board
USART3_RTS: U1.N13 (USART3_RTS); also elsewhere on the board
USART3_RX: U1.R13 (USART3_RX); also elsewhere on the board
USART3_TX: U1.R12 (USART3_TX); also elsewhere on the board
USART6_RX: U1.C10 (USART6_RX); also elsewhere on the board
USB_D+: U1.B15 (USB_OTG_FS_DP); also elsewhere on the board
USB_D-: U1.C15 (USB_OTG_FS_DM); also elsewhere on the board
~BARO2_CS_N: U1.E14 (PI0); also elsewhere on the board
~CAN2_OC: U1.P11 (PE14); also elsewhere on the board
~CAN_OC: U1.N11 (PE13); also elsewhere on the board
~CS_BMI088_ACCEL: U1.B10 (PG10); also elsewhere on the board
~CS_BMI088_GYRO: U1.B9 (PG11); also elsewhere on the board
~CS_BMI270: U1.A6 (PB5); also elsewhere on the board
~CS_EXT1: U1.K3 (PF5); also elsewhere on the board
~CS_EXT2: U1.L1 (PF10); also elsewhere on the board
~GPS_OC: U1.B12 (PD0); also elsewhere on the board
~I2C_OC: U1.R10 (PE12); also elsewhere on the board
~PERI_OC: U1.R2 (PA3); also elsewhere on the board
~SAFETY_LED: U1.J15 (PG6); also elsewhere on the board
~SERIAL4_OC: U1.P14 (PD9); also elsewhere on the board
~SERIAL5_OC: U1.P10 (PE11); also elsewhere on the board
~SPI_OC: U1.R11 (PE15); also elsewhere on the board
~TELEM1_OC: U1.C12 (PD1); also elsewhere on the board
~TELEM2_OC: U1.P15 (PD8); also elsewhere on the board

Notes on the sheet:
8 MHz
I2C Pull Up Res
13 VDD → 100nF x 13; 4.7uF VREF+ VDDA+ → 100nF; 1uF VDD33_USB → 100nF
PC13 / PC14: open-drain output Active Low

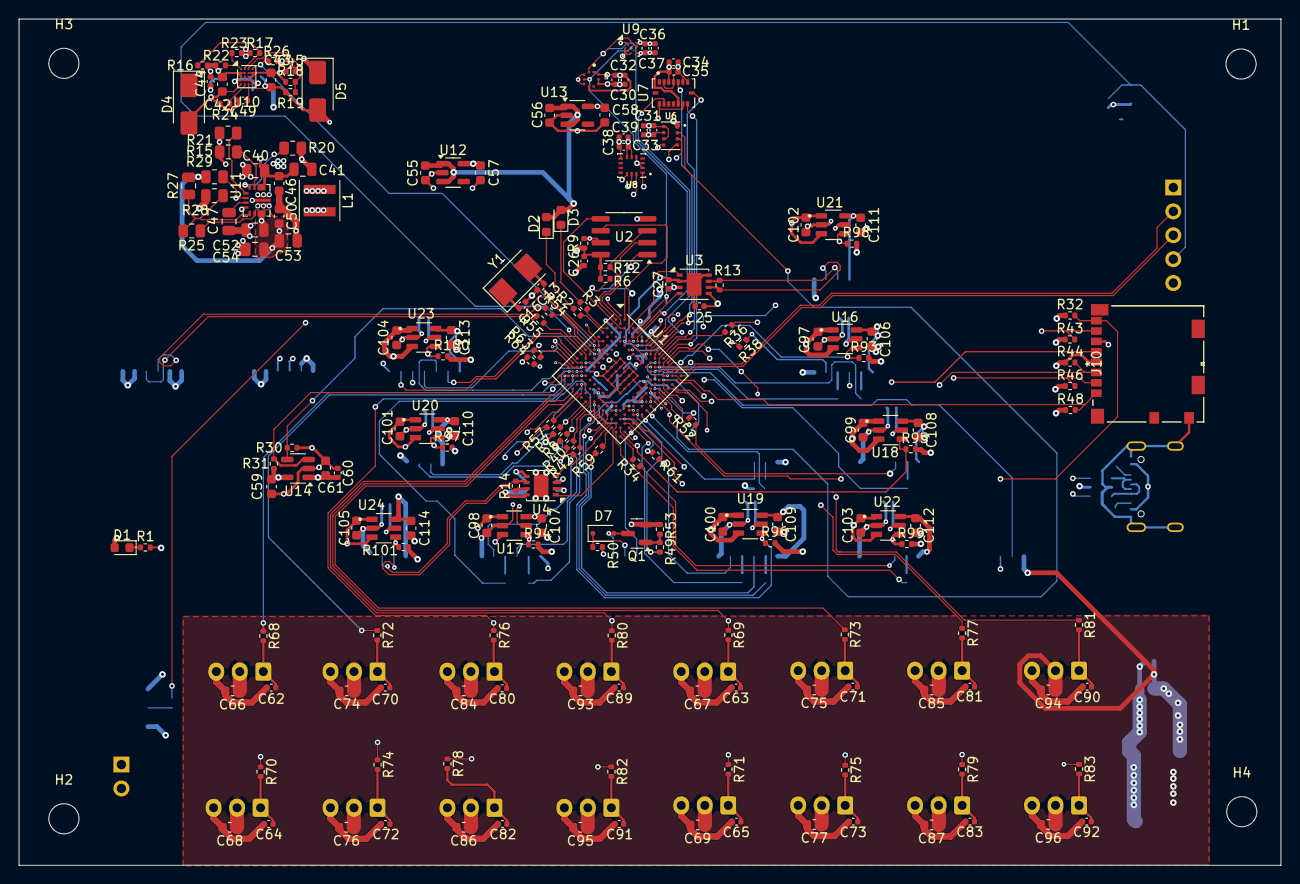
[picture p13: board SvayamV3_IIK.kicad_pcb from above]

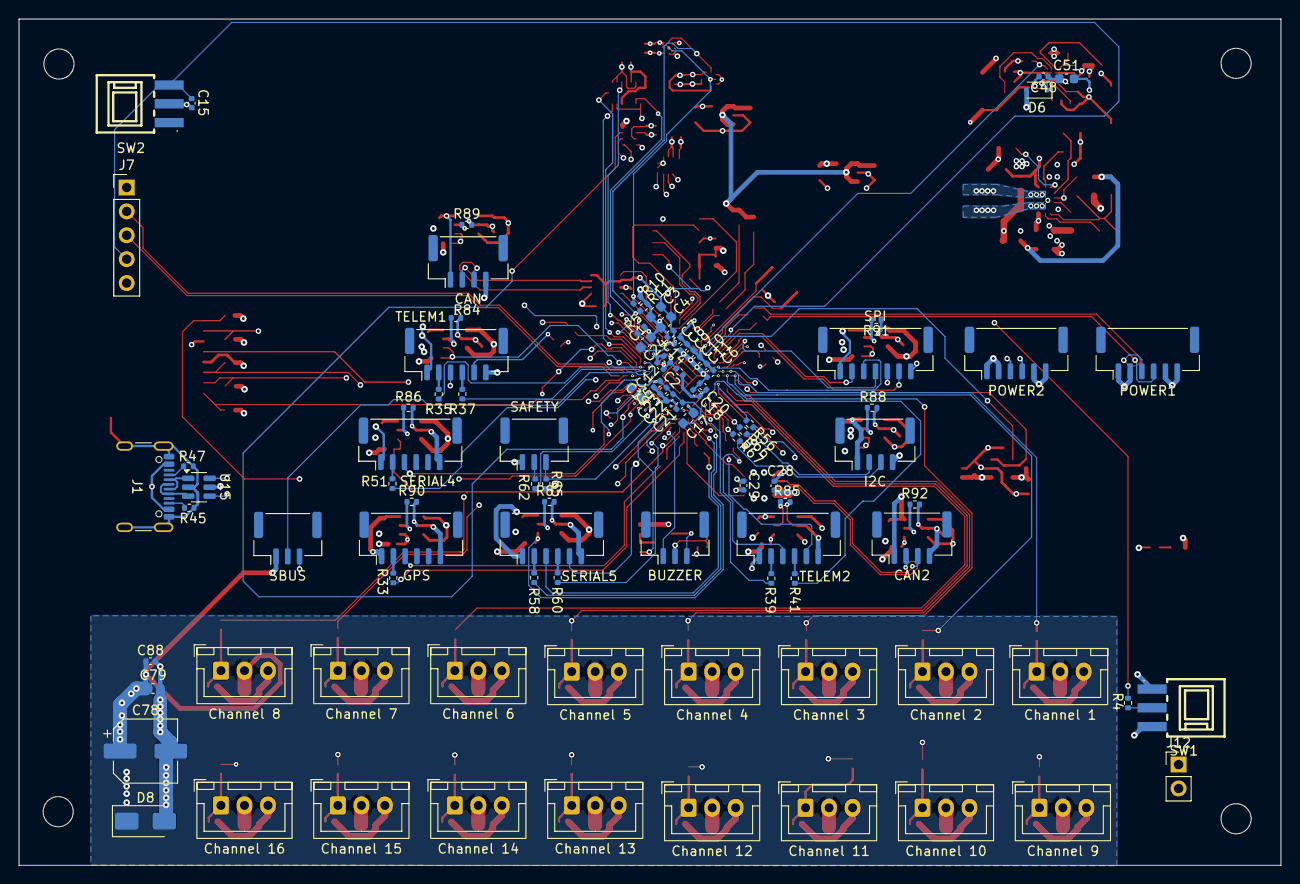
[picture p14: board SvayamV3_IIK.kicad_pcb from below]

Board: 6 copper layers, 134.1 x 90.0 mm, 290 parts (95 on the bottom side), 203 nets.
