si-nalsal/pcb-mantis/(commit log)

2026-07-16 Menyesuaikan Decoupling Cap, PullUp Resistor pada FM25CL64B, menambahkan RST Debugger.
2026-07-16 Schematic Changes on MPN and Footprint
2026-07-17 Membuat library dan memperbaiki footprint pada schematic
2026-09-16 Schematic: sensor redundancy + blok current limiter GPS (terverifikasi)
2026-09-16 Schematic: 9-port current limiter selesai (GPS..SPI, verified pass-6)
2026-09-25 Schematic: proteksi +VSERVO lengkap (TVS SMAJ6.0A + bulk + 16x1uF per-port) + konektor servo 3-pin + OC ke MCU; ERC 55 (verified)
2026-10-01 Power: fix label VIN_BB/EN - U15.VIN kini driven; ERC 54
2026-10-01 ERC: R80 DNP+100k+fp, Pin Conflicts Map lengkap; 0 errors / 17 lib-warnings (netlist diff 0, verified)
2026-10-01 Connector: RILIM CAN/CAN2 75k->47k (passive CAN splitter); RCIN J24->USART6_RX verified (0E/17W)
2026-10-01 Connector: re-annotate kanal (J30-40/J53-57) + reorder pin [S,V+,GND] (verified, ERC 0E/17W)
2026-10-01 Connector: rapikan posisi teks Reference R105-R111 (cosmetic)
2026-10-01 Annotate: renumber total semua ref (Entire+Reset+X) — netlist 1009 node identik, ERC 0E/17W
2026-10-02 Schematic: H1-H4 mounting hole -> isolated (Mechanical:MountingHole non-pad, wire+GND dihapus, footprint di-refill) — ERC 0E/17W, netlist 290/262/1005 (verified)
2026-10-02 Schematic: footprint 16 cap bank servo +VSERVO diisi (C66-C69/C74-C77/C84-C87/C93-C96 -> Capacitor_SMD:C_0603_1608Metric) — netlist 290/262/1005, ERC 0E/17W, diff 16 baris (verified); + bookkeeping p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
2026-10-02 PCB: F8 apply — 290 footprint di board (parity 0, verified)
2026-10-02 PCB: netclass — VIN_BB keluar dari Default masuk PWR (pola baru; verified)
2026-10-02 PCB: placement dimulai — re-arrange komponen oleh user (checkpoint)
2026-10-02 PCB: Board Setup selesai — presets+via 0.7/0.3, Default clearance 0.15, PWR 0.3 + PWR_MAIN 0.7/1.0-0.5, warna kelas (D-004/D-007; verified)
2026-10-02 checkpoint: remap label TIM + swap silk servo (pre-F8)
2026-10-07 DRC: restore .kicad_dru + fix rule pad/via ke Type-based; clearance 27->0 (verified kicad-cli)
2026-10-22 Schematic: swap global label TIM4_CH2 <-> TIM4_CH3 (sheet Connector)
    Perubahan: 2 global label ditukar di connector.kicad_sch.
    Efek netlist: R77.1 TIM4_CH3->TIM4_CH2, R81.1 TIM4_CH2->TIM4_CH3;
    pin MCU U1.M14/M15 tidak berubah, himpunan net identik (262=262).
    Siap F8: kedua pad belum ada copper (0 track/via).
    ERC 0E/17W (17 = lib_symbol_issues+lib_symbol_mismatch, verified kicad-cli).
2026-10-22 DRC: .kicad_dru -- 7 rule fanout BGA U1 (rule area U1_BGA) + preset track 0.1 / via 0.3-0.15
    Rule area U1_BGA BELUM ada di board (0 rule area) -> ketujuh rule inert;
    DRC baseline 1006 violations, 199 track_width 0.127 vs actual 0.100.
    Uji di salinan (area diamond L=8.0, 6 layer copper): 1006->768, 17 violasi
    nyata dari rule BGA. Detail di chat 22 Okt.
2026-10-22 PCB checkpoint sebelum F8 (setelah swap label TIM4 connector)
    290 footprint, 1412 segmen track, 312 via, 185 net sudah ada copper.
    Titik rollback sebelum Update PCB from Schematic (swap TIM4_CH2/CH3).
2026-10-25 Repo: siap publikasi — README, docs/ (STATUS·DESIGN·STACKUP·schematic·BOM·report), fabrication gate, .gitignore/.gitattributes
    - README.md: spesifikasi board, arsitektur, peta konektor, status jujur (not fab-ready)
    - docs/: STATUS.md (DRC 765 item + 6 short terdaftar), DESIGN.md (keputusan + referensi),
    STACKUP.md (6-layer 1.5584mm terverifikasi), schematic.pdf, bom.csv, board-stats.txt,
    images/ (preview PCB F+B), reports/ (ERC + DRC mentah, bertanggal)
    - fabrication/README.md: release gate + perintah ekspor gerber/drill/pos/step
    - .gitignore: whitelist + blokir .history/ output/ *-backups/ *.kicad_prl *.lck
    - untrack: .kicad_prl, 23 backup zip, Library/tps63070.pretty/catboy.kica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
2026-10-25 PCB: 7 open connection ditutup — unconnected 7->0, DRC 771->760 (321E/439W)
    Ditutup: R1.2<->J9.6 (GND), C24.2<->via (GND), U1.K4 (+3V3_FMU/VDD, pin power MCU),
    gap GND stub 0,011mm, +VBRICK1, +VBRICK2, SPI1_MISO antara U7.10<->U7.15.
    Efek samping: via_dangling 46->43, track_dangling 11->10.
    Masih terbuka: 5 short di pad MP JST-GH (J17 x2, J11) — langkah berikutnya.
    Verifikasi: kicad-cli 10.0.6 pcb drc --severity-all --schematic-parity
    unconnected 0, parity 0, 321 error / 439 warning, board 125,145x89,96 mm, 475 via.
2026-10-25 Docs: refresh status ke snapshot 23:28 — unconnected 0, DRC 760 (321E/439W), 5 short
    docs/STATUS.md:
    - Routing -> setiap net tersambung (unconnected_items 0); tabel 7 gap diganti catatan penutupan
    - Tabel DRC per rule: via_dangling 46->43, track_dangling 11->10, unconnected 7->0, shorting 6->5
    - 'The six shorts' -> 'The five shorts': 5 via di 3 pad MP (J17 x2, J11) + risiko +5V short
    bila MP di-assign GND sebelum via dipindah; tambah audit pad-level (0 pad kehilangan net)
    - Next steps: urutan baru (pindah via -> assign MP->GND -> rule area BGA -> dst)
    - Snapshot: commit a56f437, branch main
    README.md:
    - Banner status: 0 open connection, 5 shorts (semua pad MP)
    - Statistik board: segment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
2026-10-25 PCB: 3 via GND keluar dari pad MP (J17 kanan, J11) — DRC 760->752, short nyata 0
    Fungsi: unconnected 0, parity 0, short antar dua net nyata 0. 2 shorting_items sisa
    adalah via +5V_PERIPH di dalam pad MP kiri J17 (MP tanpa net -> bukan short aktif,
    tapi jadi +5V-GND kalau MP di-assign GND sebelum via dipindah).
    Perubahan angka (23:28 -> 23:35):
    - shorting_items 5 -> 2 solder_mask_bridge 17 -> 14
    - hole_clearance 24 -> 22 hole_to_hole 15 -> 14
    - clearance 27 -> 28 (+1, area fanout BGA)
    - total 760 -> 752 (313 error / 439 warning)
    Docs: README + STATUS.md disinkronkan; docs/reports + docs/board-stats.txt di-refresh.
    Verifikasi: kicad-cli 10.0.6 pcb drc --severity-all --schematic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
2026-11-04 Lib: simbol switch PS-5850SVA-3PL/3PN + PS-5824SVB-6PL, footprint & 3D model EasyEDA
    - Library/Svayam/Svayam.kicad_sym (baru, format v10): PS-5850SVA-3PL (latch), PS-5850SVA-3PN (momentary), PS-5824SVB-6PL (latch 6P)
    - easyeda2kicad.kicad_sym: tambah PS-5824SVB-6PL
    - easyeda2kicad.pretty + 3dshapes: SW-SMD_G-SWITCH_PS-5850SVX-3PL (dipakai SW1/SW2), SW-SMD_6P-L5.8-W5.8-P2.00-LS11.3 (stok library)
    - Svayam.pretty: tambah path model 3D (104031-0811_MOL SIM, SOT95P280X145-6N)
    - sym-lib-table: daftarkan lib Svayam (${KIPRJMOD}/Library/Svayam/Svayam.kicad_sym)
2026-11-04 SCH: SW1/SW2 pakai PS-5850SVA-3PL (latch BOOT0) dan -3PN (momentary NRST); DNP konektor servo dilepas
    - microcontroller.kicad_sch: instance SW1 (PS-5850SVA-3PL, latch) dan SW2 (PS-5850SVA-3PN, momentary) + simbol tersemat
    - connector.kicad_sch: 16 konektor J2-J18 berubah dnp yes -> dnp no (ikut BOM/perakitan)
2026-11-04 PCB: update board 04 Nov 2026 — 290 footprint, 2918 segmen, 424 via, 8 zone
    Snapshot kerja terbaru (file disimpan 2026-11-04 20:51 WIB). Terhadap a63baa4: segmen 2900 -> 2918, via 475 -> 424, footprint tetap 290; blok footprint ditulis ulang KiCad sehingga diff tampak besar. Status DRC belum diukur ulang sesi ini.
2026-11-04 Docs: STATUS snapshot pasca unroute global #3 (re-placement)
    Catatan: angka di STATUS (1328 segmen / 347 via) adalah kondisi 30 Okt; board di commit sebelumnya sudah bergerak lagi — perlu refresh.
2026-11-04 Docs: status project 04 Nov 2026 — unconnected 0, parity 0, DRC 579 (174E/405W)
    Diukur ulang dengan kicad-cli 10.0.6, bukan warisan snapshot lama:
    - pcb drc --schematic-parity: 579 violation (174 error / 405 warning), unconnected_items 0, parity 0
    - routing: 2918 segmen (F 1639 / B 746 / In2 400 / In3 133), 424 via, 8 zone
    - net: 263 net, 204 ber-copper, 59 tanpa copper (semua unconnected- single-pin), 0 net fungsional tanpa copper
    - board: 120.925 x 89.960 mm, min track 0.10 mm, min drill 0.15 mm (47 via)
    - ERC: 0 error, 17 warning (9 lib_symbol_mismatch + 8 lib_symbol_issues)
    - BOM: 88 line, 277 ref, 39 MPN, 2 LCSC (SW1/SW2)
    Temuan baru yang dicatat: H1-H4 masih di X=223.775 (luar outli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
2026-11-04 Docs: koreksi rincian clearance/track_width STATUS (angka dari DRC JSON, bukan taksiran)
    clearance 26: 6 di fan-out U1_BGA (min 0.0916 vs 0.120), 8 pad/via-to-pad/via (0.1018), 6 track spacing outer (0.100), 5 lain, 1 track-to-pad (0.1865 vs 0.200) - 4 di antaranya di luar area BGA.
2026-11-09 chore(pcb): checkpoint layout and design rules
2026-11-13 release: SvayamV3_IIK STM32H743IIK6 (UFBGA176+25) fabrication package
    Snapshot of the board before the MCU package change.
    Design changes
    - U11 (TPS63070) footprint attr set to SMD; via-in-pad DRC rules for the
    U11->L1 vias.
    - R93-R101 included in BOM; LCSC/MPN fields on all assembled parts.
    - Alternatives for out-of-stock parts:
    U6 DPS310XTSA1 -> DPS368XTSA1 (C3232508)
    L1 XFL4020-152 -> XGL4020-152MEC (C7417180)
    C78 16CE220AX -> VT1C221M0607 (C90274)
    R86,R87 75k -> 0402WGF7502TCE (C25798)
    R88,R91 110k -> 0402WGF1103TCE (C25745)
    Fabrication outputs
    - fabrication/gerbers + SvayamV3_IIK-gerber-JLCPCB.zip (13 gerbers + PTH/NPTH)
    - fabrication/jlcpcb_20261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
